YunBeeeen/Capstone/docs/media/SOURCES.md

# Media sources

- User-provided project portfolio: https://app.notion.com/p/3d252aba4c2a8006b0cac70a0ea84957
- User-provided PowerPoint: 포트폴리오_엄윤빈.pptx
- Photos and diagrams were extracted from those sources. Images were resized and optimized; transparent diagrams were placed on a white background for readability.
- Uploaded demo videos were transcoded to H.264 MP4 without audio. GIFs are short excerpts for README previews and do not represent a complete evaluation.
