YunBeeeen/Capstone/capstone_ws/src/description/meshes/mobile/wheel_fr_link.stl

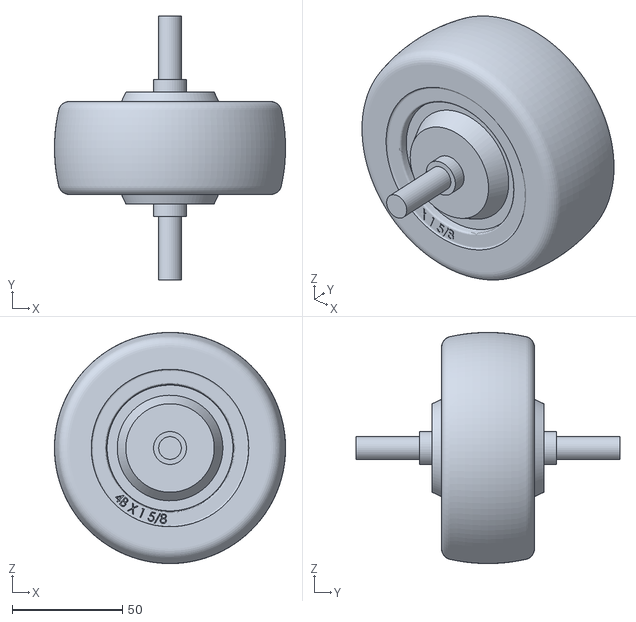
[picture p3: CAD file, 2026-11-08]
capstone_ws/src/description/meshes/mobile/wheel_fr_link.stl
105.0 x 119.9 x 105.0
