YunBeeeen/Capstone/capstone_ws/src/description/meshes/right_arm/camera/mounts/D435_Gemini2_Mount.stl

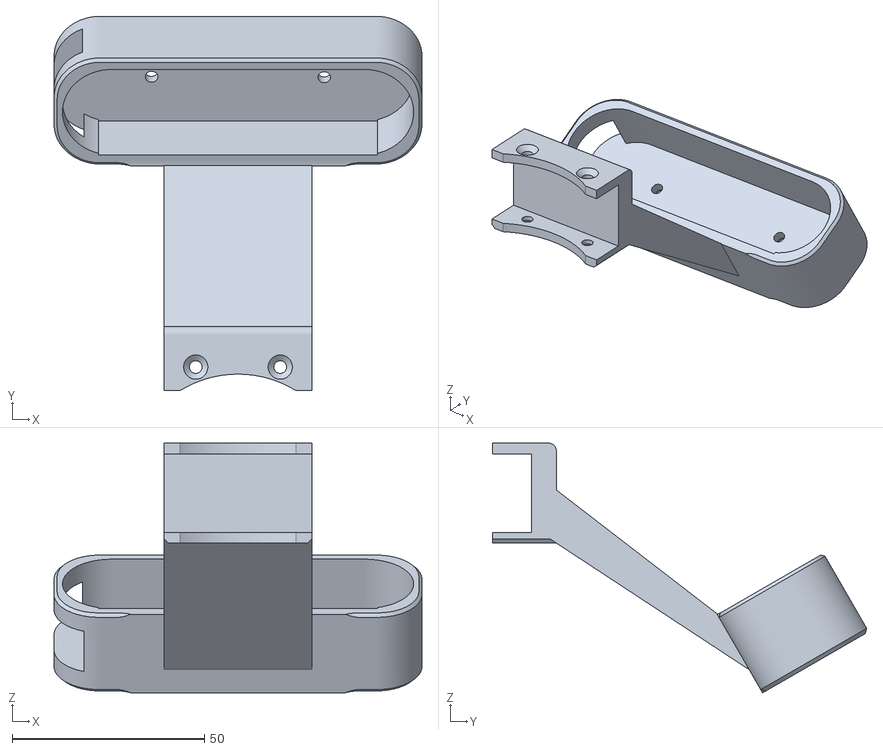
[picture p4: CAD file, 2026-11-08]
capstone_ws/src/description/meshes/right_arm/camera/mounts/D435_Gemini2_Mount.stl
95.8 x 97.4 x 65.0
