YunBeeeen/Capstone/capstone_ws/src/description/meshes/right_arm/camera/realsense/d435_1.stl

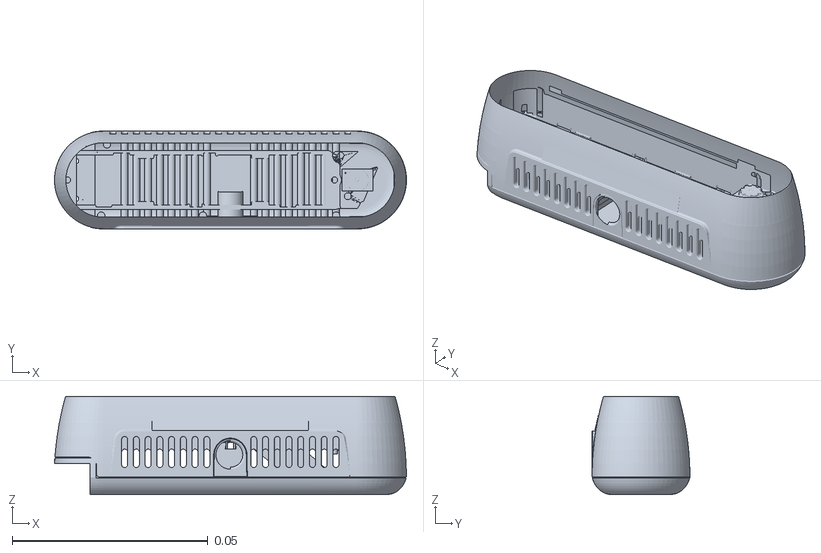
[picture p5: CAD file, 2026-11-08]
capstone_ws/src/description/meshes/right_arm/camera/realsense/d435_1.stl
0.0899 x 0.025 x 0.0251
