YunBeeeen/Capstone/capstone_ws/src/description/meshes/right_arm/collision/link2.STL

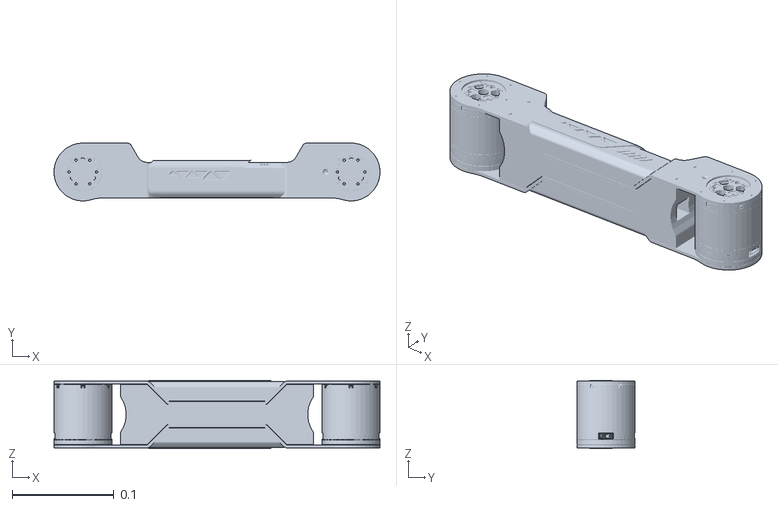
[picture p6: CAD file, 2026-11-08]
capstone_ws/src/description/meshes/right_arm/collision/link2.STL
0.321 x 0.057 x 0.0674
