YunBeeeen/Capstone/capstone_ws/src/description/meshes/right_arm/shared/colored_left_finger_carriage_grey.stl

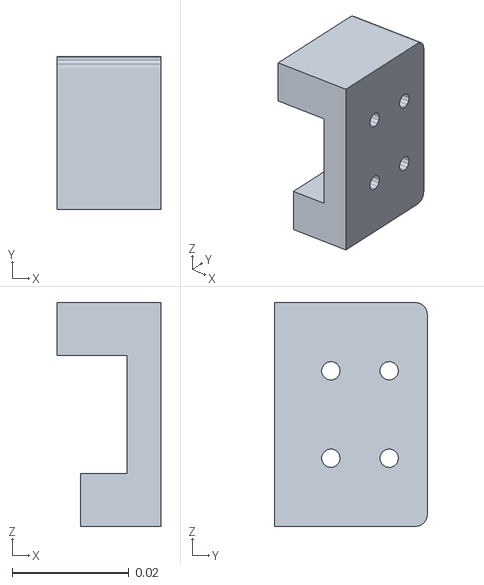
[picture p7: CAD file, 2026-11-08]
capstone_ws/src/description/meshes/right_arm/shared/colored_left_finger_carriage_grey.stl
0.0178 x 0.0262 x 0.0384
