YunBeeeen/Capstone/capstone_ws/src/description/meshes/right_arm/visual/colored_gripper_base_metal.stl

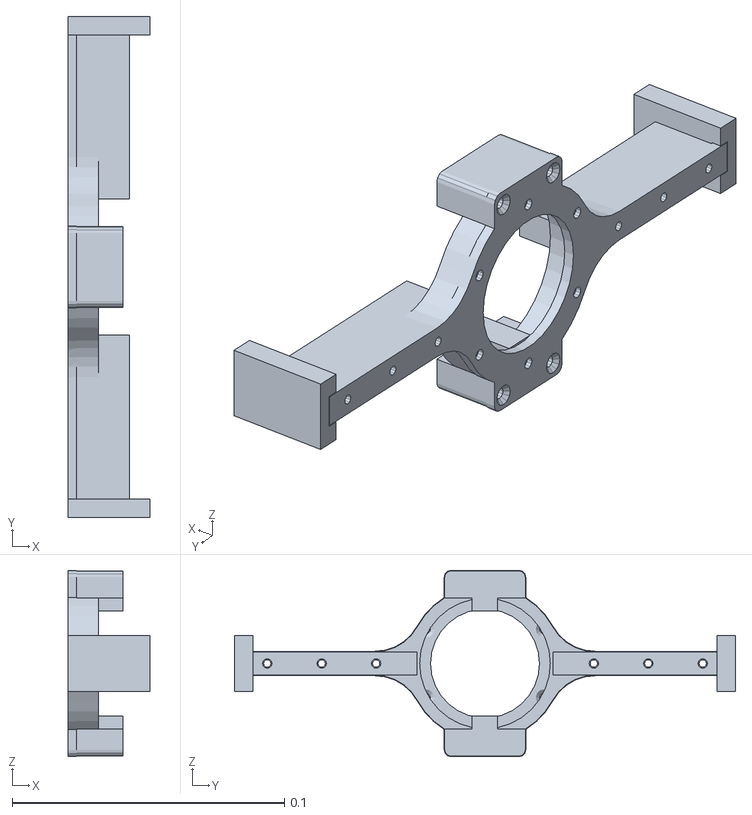
[picture p8: CAD file, 2026-11-08]
capstone_ws/src/description/meshes/right_arm/visual/colored_gripper_base_metal.stl
0.03 x 0.184 x 0.0685
