YunBeeeen/Capstone/capstone_ws/src/description/meshes/right_arm/camera/realsense/d435_0.stl

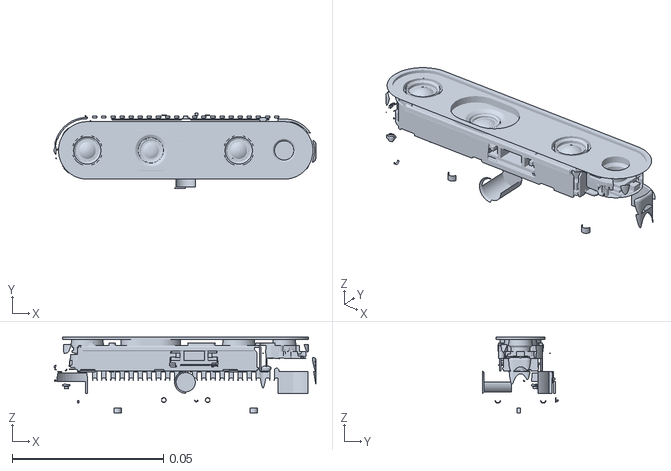
[picture p9: CAD file, 2026-11-08]
capstone_ws/src/description/meshes/right_arm/camera/realsense/d435_0.stl
0.0865 x 0.025 x 0.025
