YunBeeeen/Capstone/capstone_ws/src/description/meshes/right_arm/collision/left_finger.stl

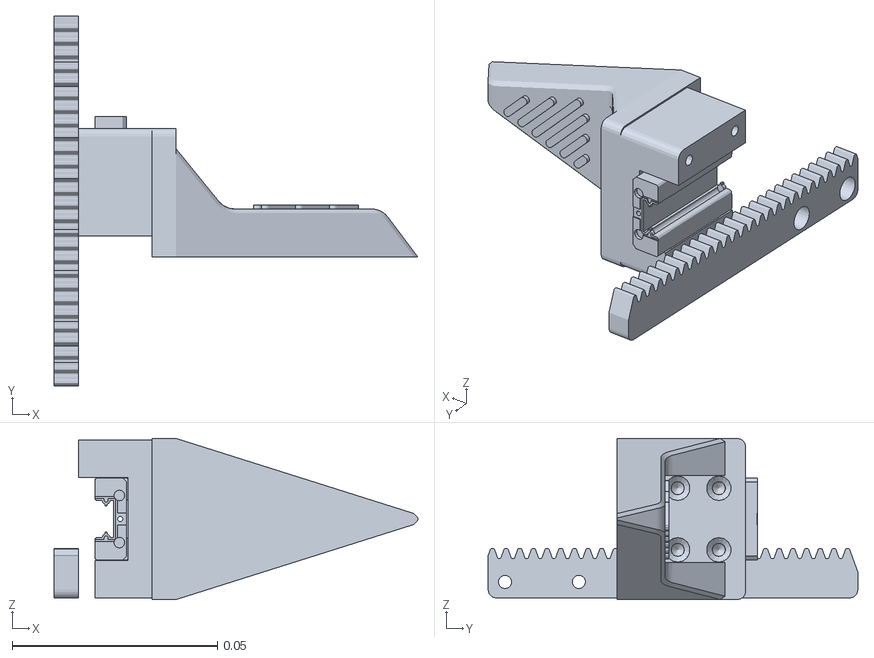
[picture p10: CAD file, 2026-11-08]
capstone_ws/src/description/meshes/right_arm/collision/left_finger.stl
0.0886 x 0.09 x 0.0392
