YunBeeeen/Capstone/capstone_ws/src/description/meshes/right_arm/shared/colored_right_finger_carriage_grey.stl

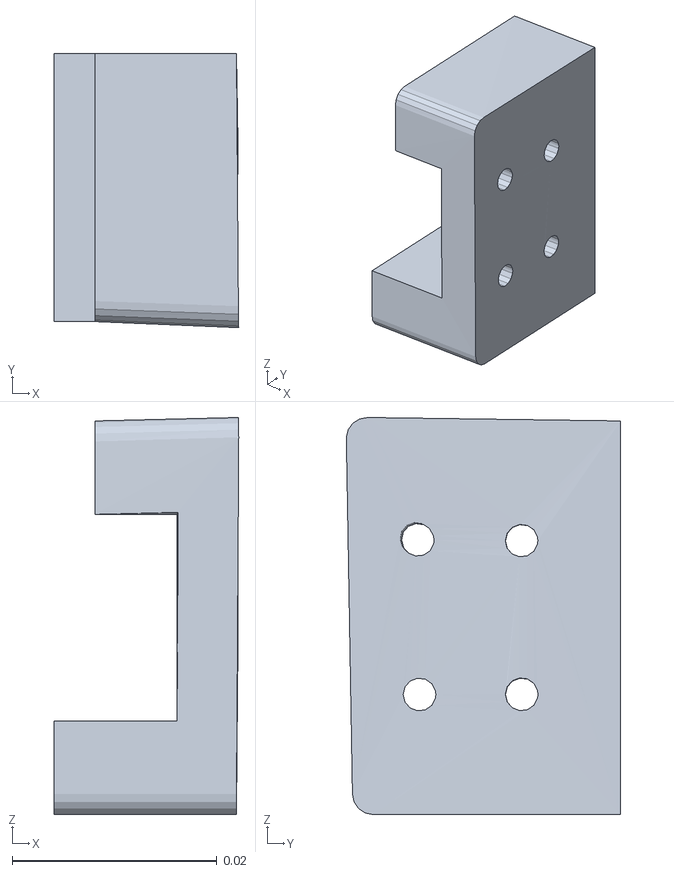
[picture p11: CAD file, 2026-11-08]
capstone_ws/src/description/meshes/right_arm/shared/colored_right_finger_carriage_grey.stl
0.018 x 0.0268 x 0.0388
