YunBeeeen/Capstone/capstone_ws/src/description/meshes/right_arm/visual/colored_link2_anodized_grey.stl

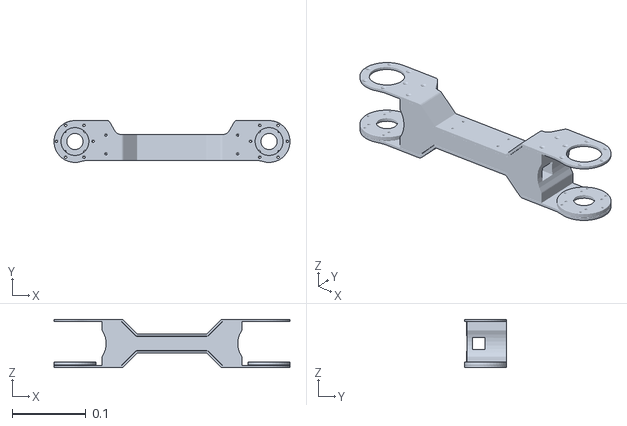
[picture p12: CAD file, 2026-11-08]
capstone_ws/src/description/meshes/right_arm/visual/colored_link2_anodized_grey.stl
0.321 x 0.057 x 0.0658
