YunBeeeen/Capstone/capstone_ws/src/description/meshes/mobile/steering_fl_link.stl

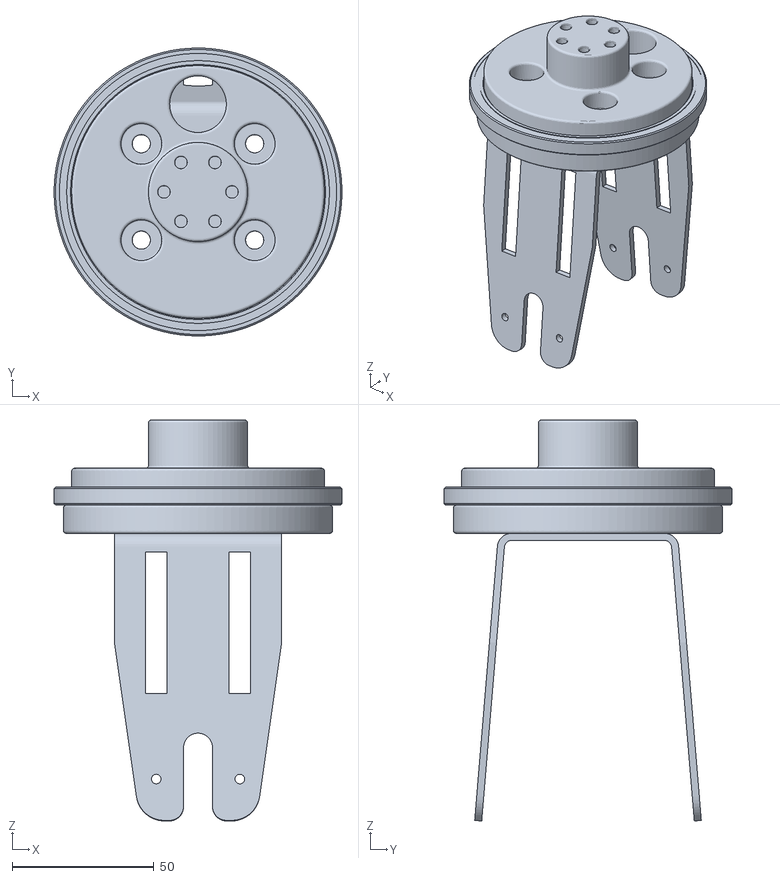
[picture p13: CAD file, 2026-11-08]
capstone_ws/src/description/meshes/mobile/steering_fl_link.stl
101.6 x 101.6 x 141.5
