YunBeeeen/Capstone/capstone_ws/src/description/meshes/right_arm/collision/link6.STL

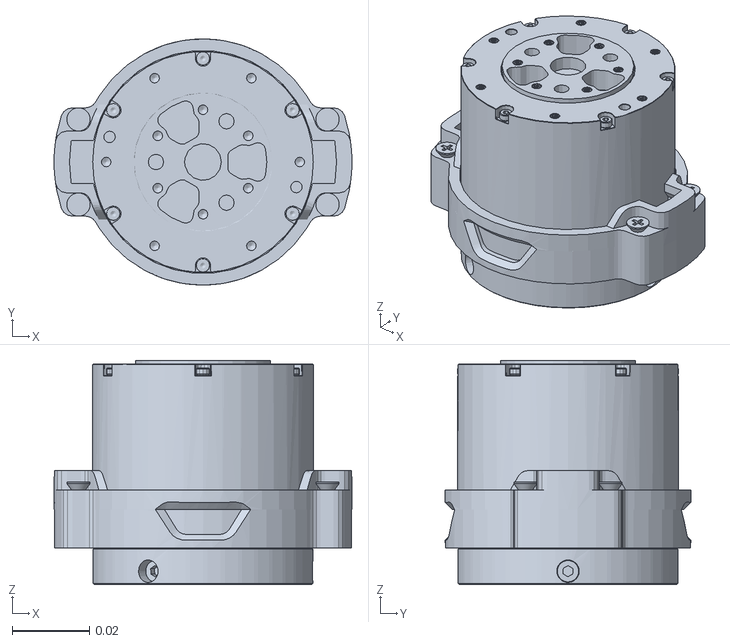
[picture p14: CAD file, 2026-11-08]
capstone_ws/src/description/meshes/right_arm/collision/link6.STL
0.077 x 0.0636 x 0.058
