YunBeeeen/Capstone/capstone_ws/src/description/meshes/right_arm/shared/colored_right_finger_travel_stop_yellow.stl

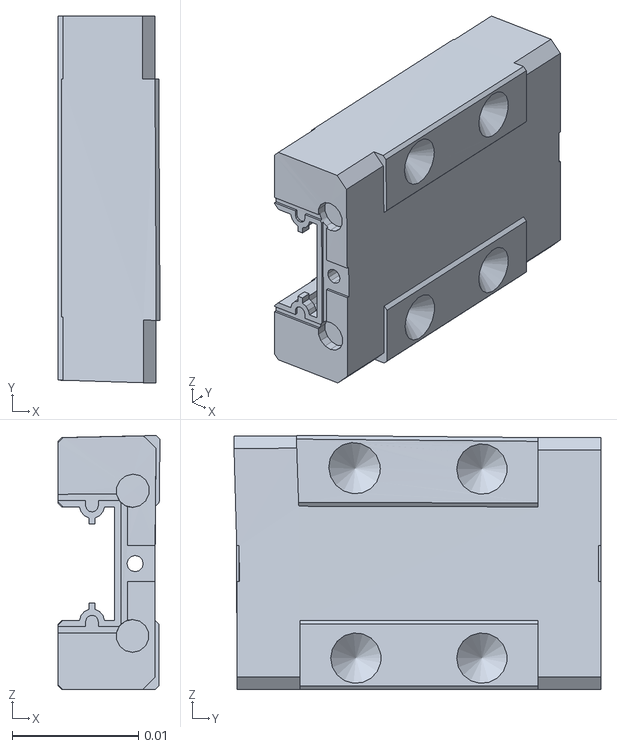
[picture p15: CAD file, 2026-11-08]
capstone_ws/src/description/meshes/right_arm/shared/colored_right_finger_travel_stop_yellow.stl
0.0081 x 0.0291 x 0.0202
