YunBeeeen/Capstone/capstone_ws/src/description/meshes/right_arm/visual/colored_link3_hardware_black.stl

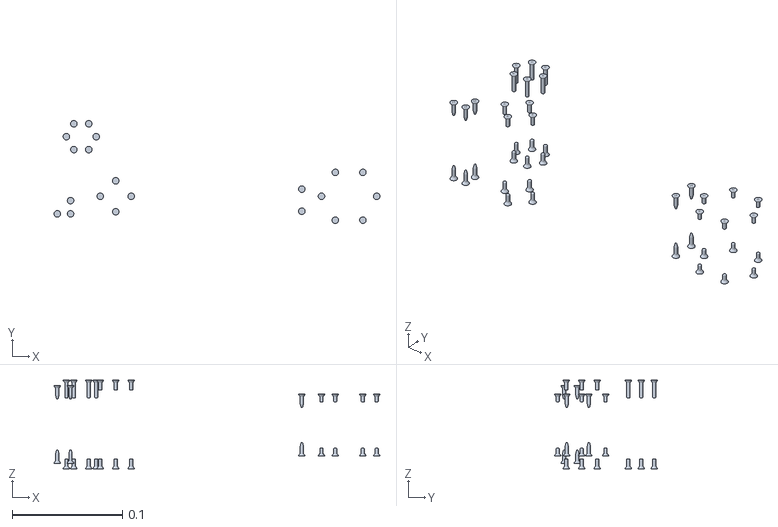
[picture p16: CAD file, 2026-11-08]
capstone_ws/src/description/meshes/right_arm/visual/colored_link3_hardware_black.stl
0.295 x 0.0933 x 0.0802
