YunBeeeen/Capstone/capstone_ws/src/description/meshes/mobile/lift_stage_2_link.stl

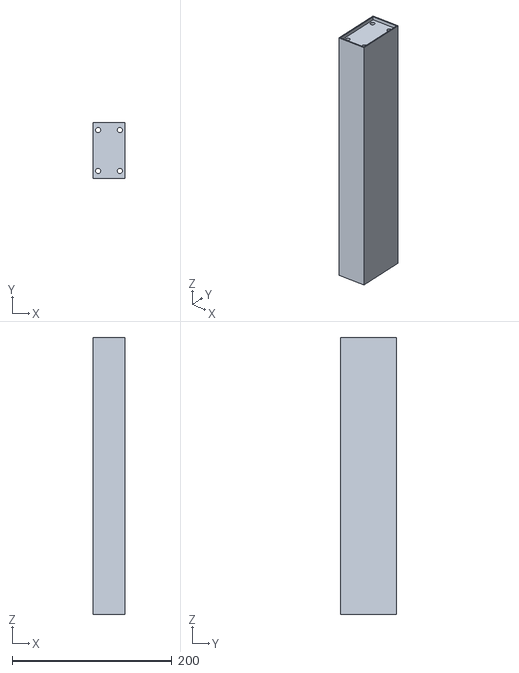
[picture p17: CAD file, 2026-11-08]
capstone_ws/src/description/meshes/mobile/lift_stage_2_link.stl
40.3 x 70.3 x 347.0
