YunBeeeen/Capstone/capstone_ws/src/description/meshes/right_arm/collision/gripper_base.stl

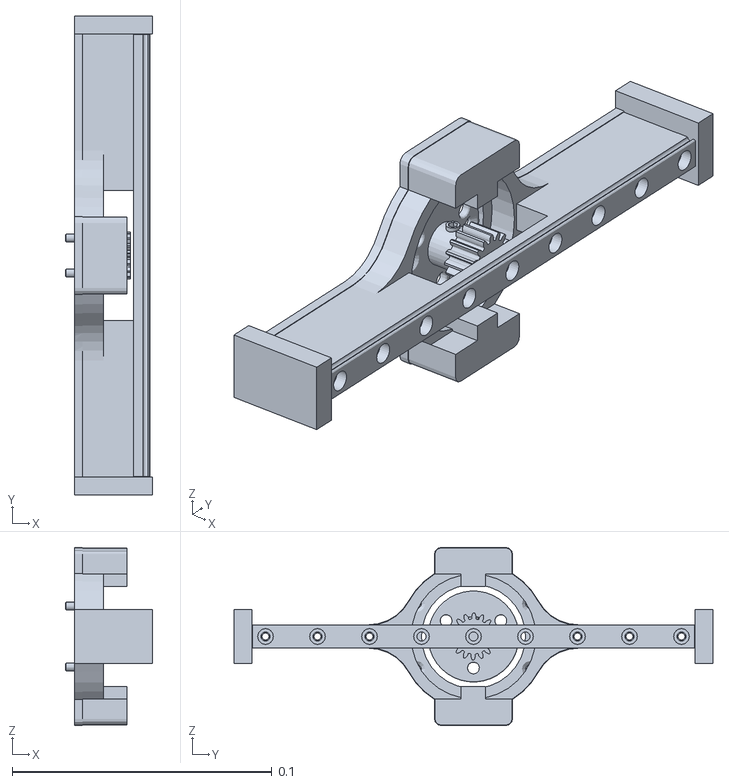
[picture p18: CAD file, 2026-11-08]
capstone_ws/src/description/meshes/right_arm/collision/gripper_base.stl
0.0335 x 0.184 x 0.0685
