YunBeeeen/Capstone/capstone_ws/src/description/meshes/right_arm/shared/colored_left_finger_travel_stop_yellow.stl

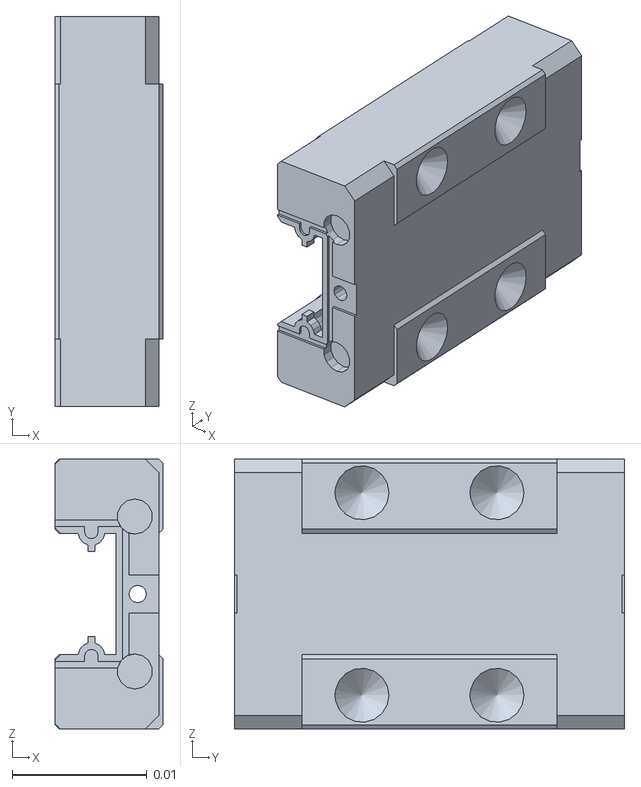
[picture p19: CAD file, 2026-11-08]
capstone_ws/src/description/meshes/right_arm/shared/colored_left_finger_travel_stop_yellow.stl
0.008 x 0.0289 x 0.02
