YunBeeeen/Capstone/capstone_ws/src/description/meshes/right_arm/visual/colored_base_link_silver_trim.stl

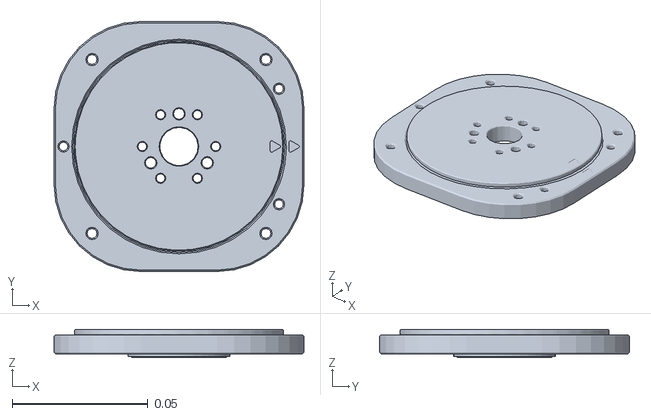
[picture p20: CAD file, 2026-11-08]
capstone_ws/src/description/meshes/right_arm/visual/colored_base_link_silver_trim.stl
0.092 x 0.092 x 0.0103
