YunBeeeen/Capstone/capstone_ws/src/description/meshes/mobile/front_camera_link.stl

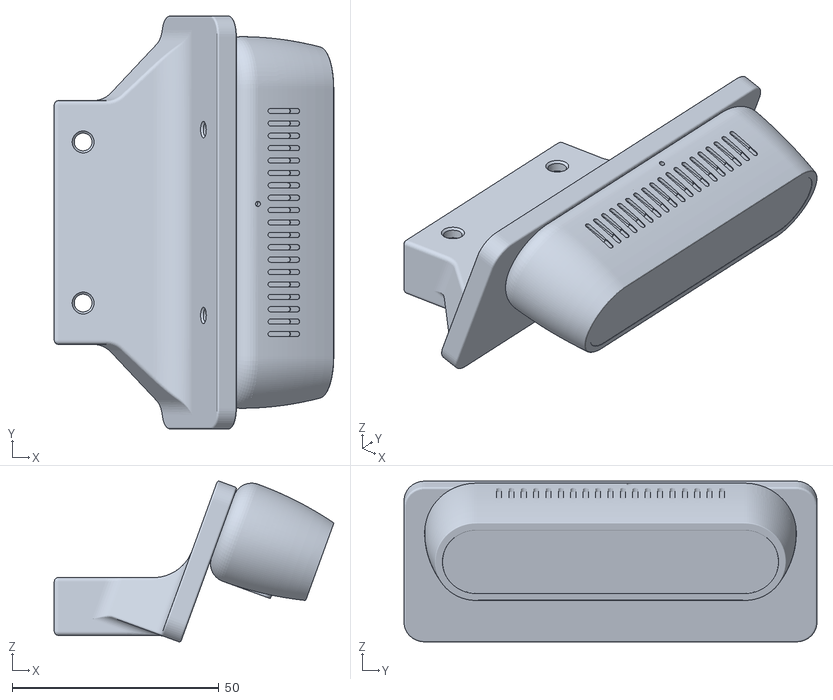
[picture p21: CAD file, 2026-11-08]
capstone_ws/src/description/meshes/mobile/front_camera_link.stl
67.7 x 100.0 x 38.9
