YunBeeeen/Capstone/capstone_ws/src/description/meshes/right_arm/collision/right_finger.stl

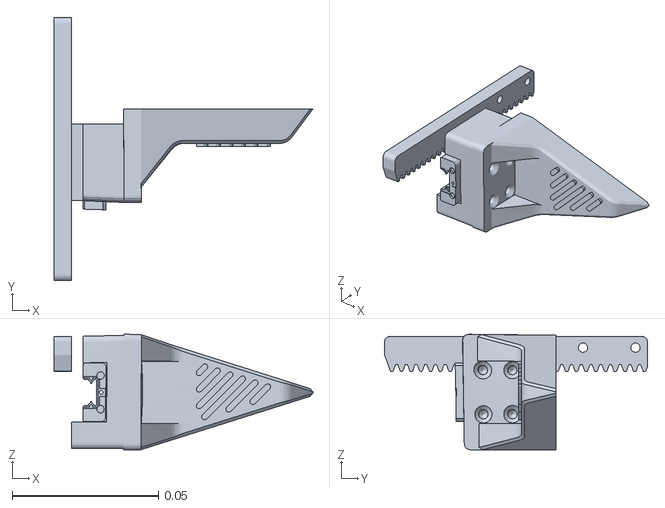
[picture p22: CAD file, 2026-11-08]
capstone_ws/src/description/meshes/right_arm/collision/right_finger.stl
0.0886 x 0.09 x 0.0395
