YunBeeeen/Capstone/capstone_ws/src/description/meshes/right_arm/visual/colored_link4_hardware_black.stl

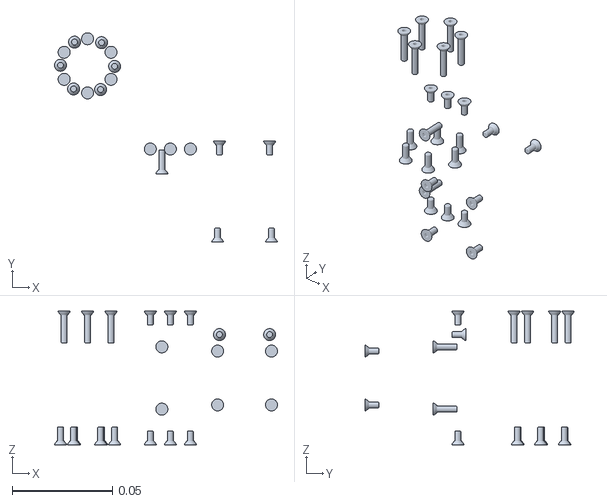
[picture p23: CAD file, 2026-11-08]
capstone_ws/src/description/meshes/right_arm/visual/colored_link4_hardware_black.stl
0.111 x 0.104 x 0.0668
