YunBeeeen/Capstone/capstone_ws/src/description/meshes/right_arm/collision/link5.STL

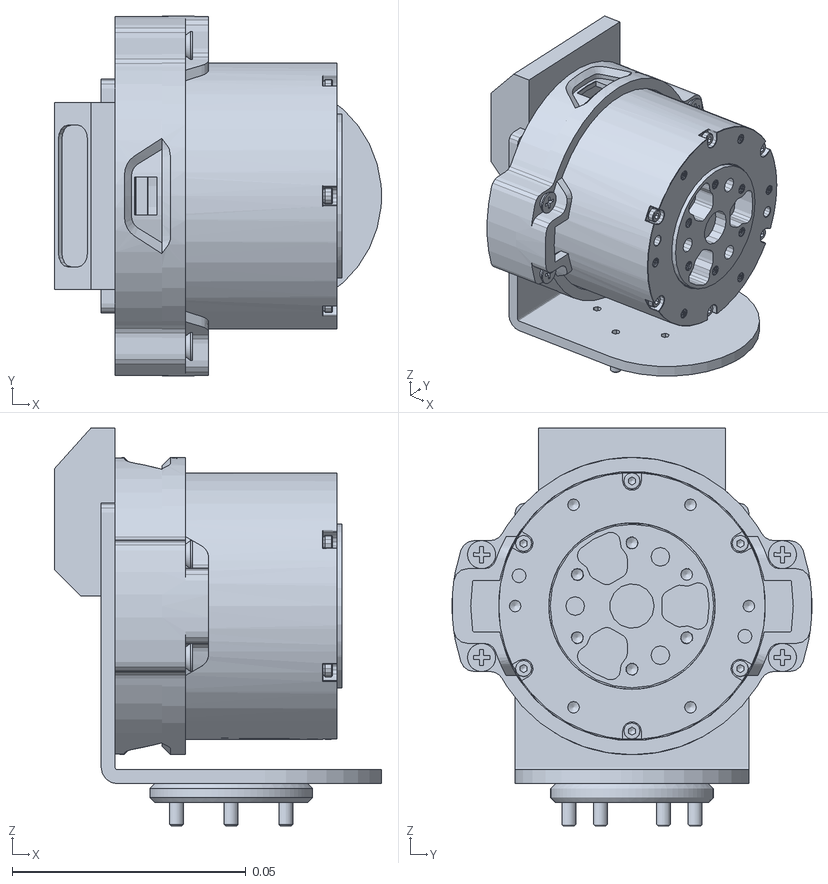
[picture p24: CAD file, 2026-11-08]
capstone_ws/src/description/meshes/right_arm/collision/link5.STL
0.07 x 0.077 x 0.085
