YunBeeeen/Capstone/capstone_ws/src/description/meshes/right_arm/visual/colored_link5_anodized_grey.stl

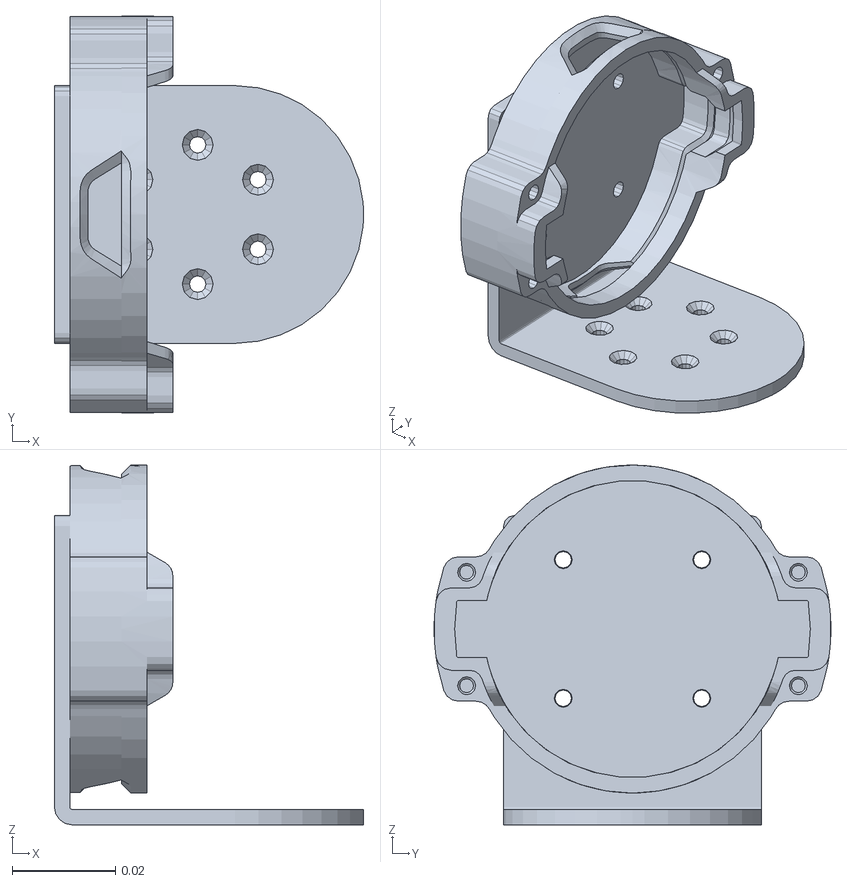
[picture p25: CAD file, 2026-11-08]
capstone_ws/src/description/meshes/right_arm/visual/colored_link5_anodized_grey.stl
0.06 x 0.077 x 0.0698
