YunBeeeen/Capstone/capstone_ws/src/description/meshes/right_arm/collision/link4.STL

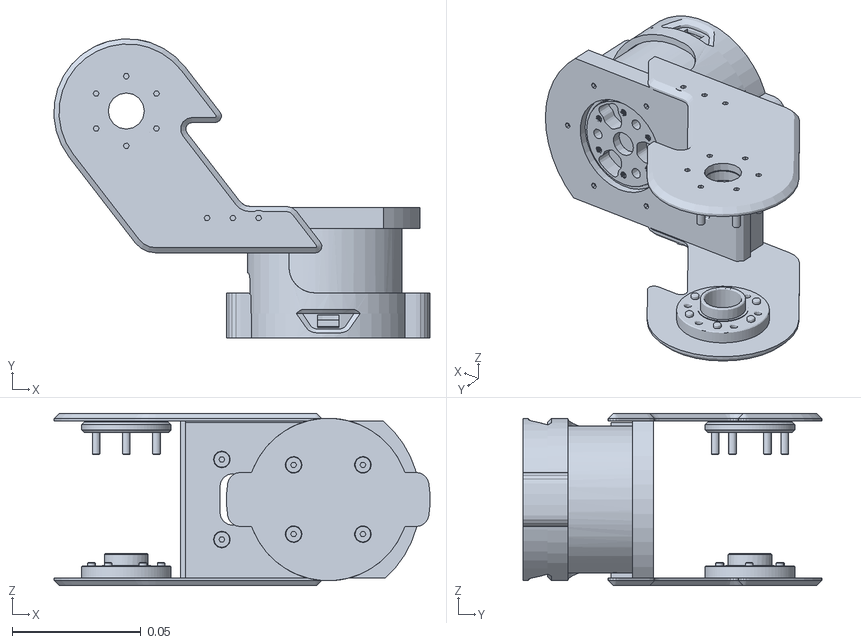
[picture p26: CAD file, 2026-11-08]
capstone_ws/src/description/meshes/right_arm/collision/link4.STL
0.146 x 0.116 x 0.0668
