YunBeeeen/Capstone/capstone_ws/src/description/meshes/right_arm/visual/colored_link5_matte_black.stl

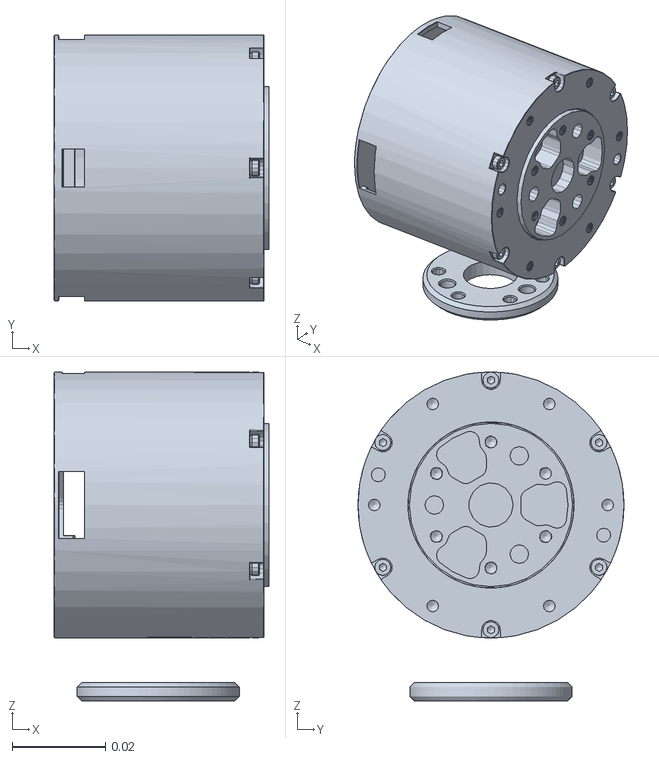
[picture p27: CAD file, 2026-11-08]
capstone_ws/src/description/meshes/right_arm/visual/colored_link5_matte_black.stl
0.046 x 0.057 x 0.0705
