YunBeeeen/Capstone/capstone_ws/src/description/meshes/mobile/base_link.stl

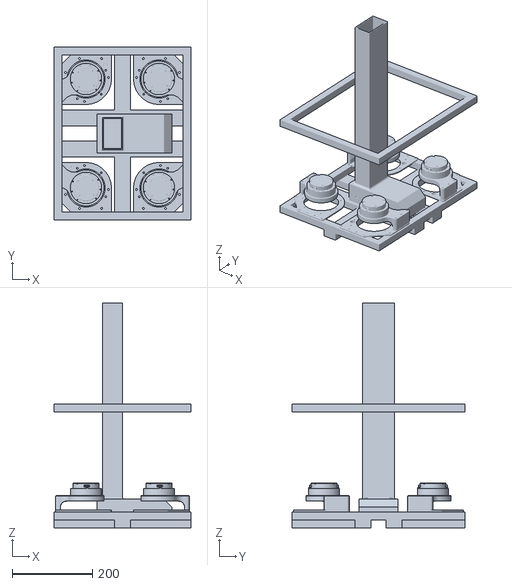
[picture p28: CAD file, 2026-11-08]
capstone_ws/src/description/meshes/mobile/base_link.stl
341.9 x 431.8 x 562.0
