YunBeeeen/Capstone/capstone_ws/src/description/meshes/right_arm/collision/link1.STL

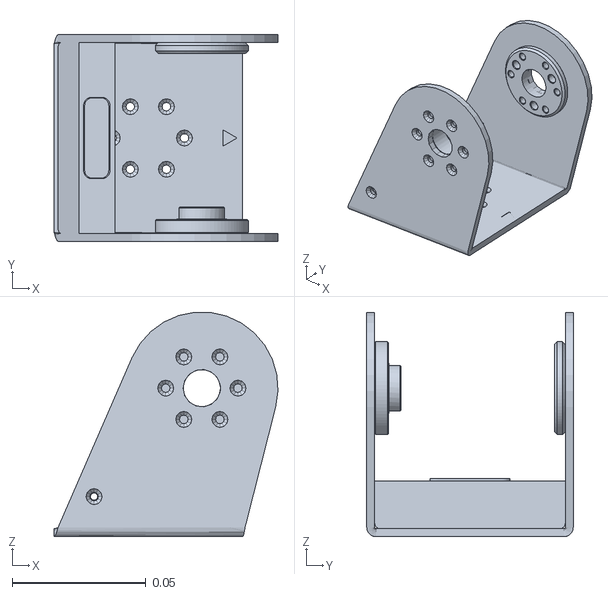
[picture p29: CAD file, 2026-11-08]
capstone_ws/src/description/meshes/right_arm/collision/link1.STL
0.0838 x 0.0772 x 0.0839
