YunBeeeen/Capstone/capstone_ws/src/description/meshes/right_arm/visual/colored_gripper_base_hardware_black.stl

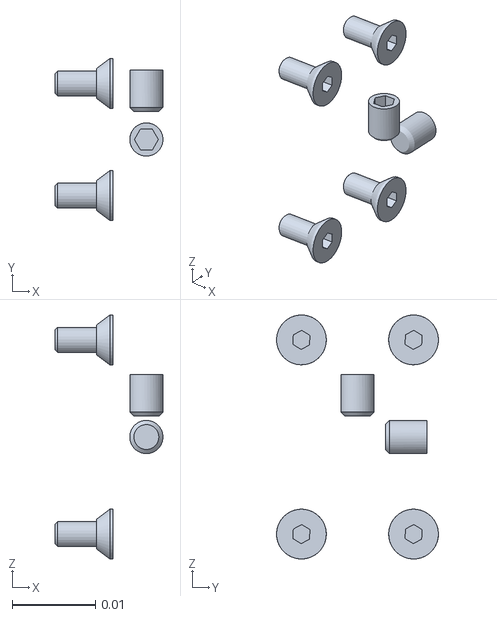
[picture p30: CAD file, 2026-11-08]
capstone_ws/src/description/meshes/right_arm/visual/colored_gripper_base_hardware_black.stl
0.013 x 0.0195 x 0.0294
