YunBeeeen/Capstone/capstone_ws/src/description/meshes/mobile/top_plate_link.stl

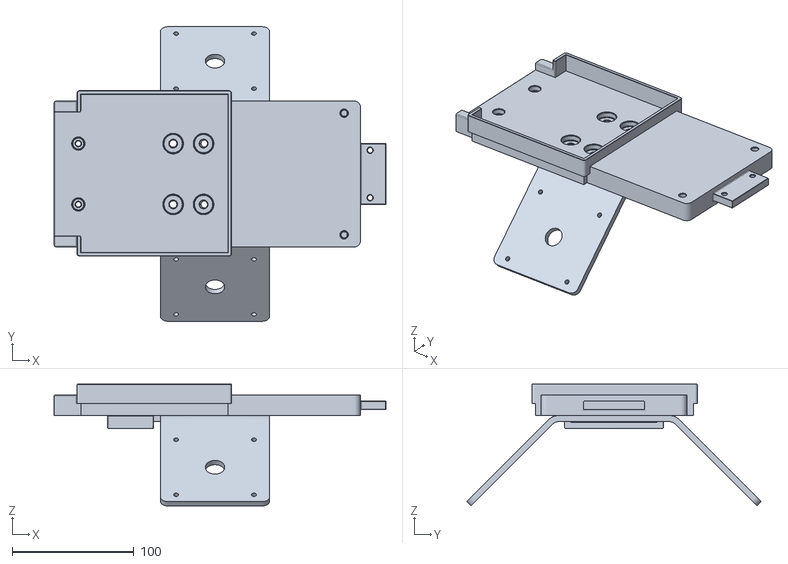
[picture p31: CAD file, 2026-11-08]
capstone_ws/src/description/meshes/mobile/top_plate_link.stl
273.0 x 242.2 x 100.2
