YunBeeeen/Capstone/capstone_ws/src/description/meshes/right_arm/collision/base_link_no_plate.stl

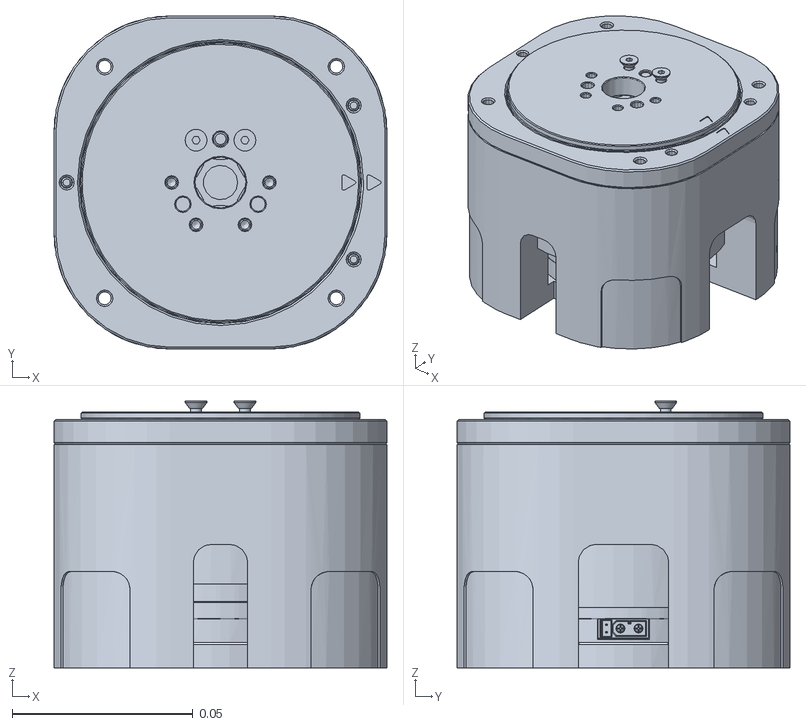
[picture p32: CAD file, 2026-11-08]
capstone_ws/src/description/meshes/right_arm/collision/base_link_no_plate.stl
0.092 x 0.092 x 0.0737
