YunBeeeen/Capstone/capstone_ws/src/description/meshes/right_arm/visual/colored_base_link_hardware_black_no_plate.stl

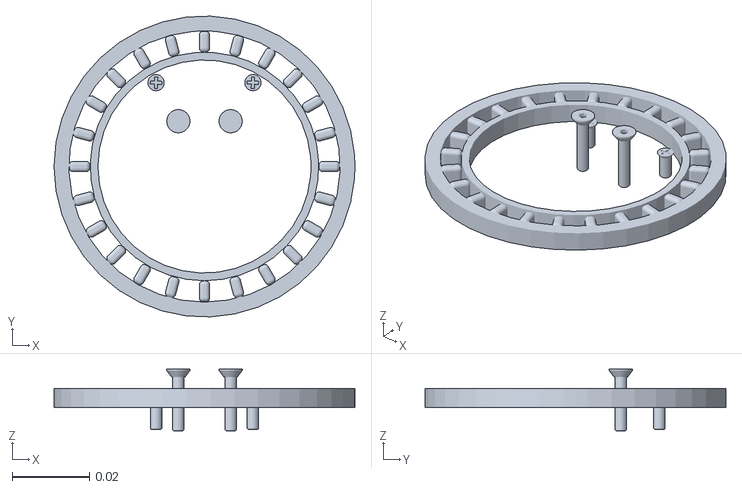
[picture p33: CAD file, 2026-11-08]
capstone_ws/src/description/meshes/right_arm/visual/colored_base_link_hardware_black_no_plate.stl
0.0777 x 0.0776 x 0.016
