YunBeeeen/Capstone/capstone_ws/src/description/meshes/right_arm/collision/link3.STL

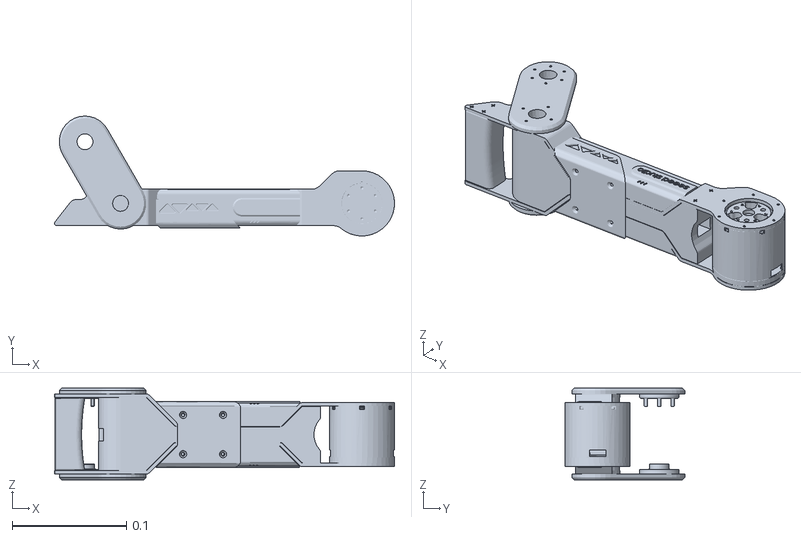
[picture p34: CAD file, 2026-11-08]
capstone_ws/src/description/meshes/right_arm/collision/link3.STL
0.298 x 0.105 x 0.0802
