YunBeeeen/Capstone/capstone_ws/src/description/meshes/right_arm/visual/colored_link4_anodized_grey.stl

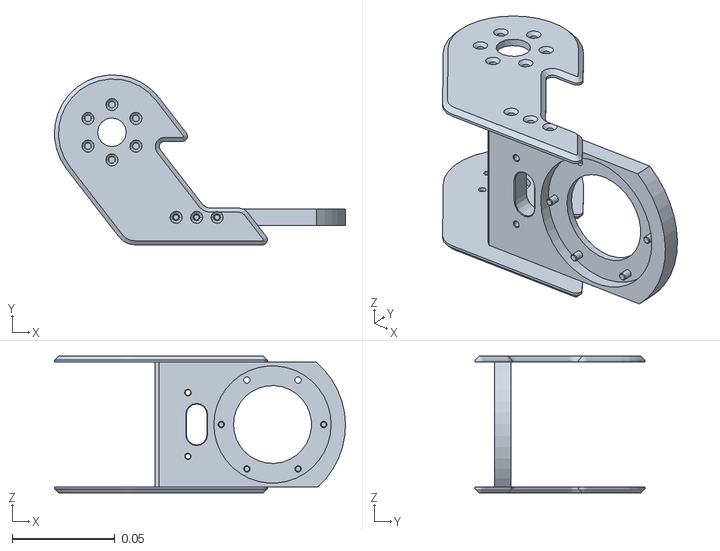
[picture p35: CAD file, 2026-11-08]
capstone_ws/src/description/meshes/right_arm/visual/colored_link4_anodized_grey.stl
0.142 x 0.0829 x 0.0668
