YunBeeeen/Capstone/capstone_ws/src/description/meshes/mobile/lift_stage_1_link.stl

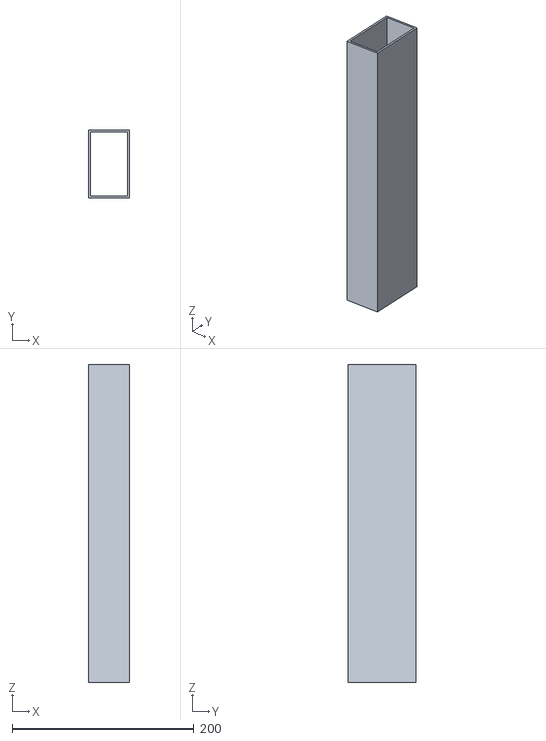
[picture p36: CAD file, 2026-11-08]
capstone_ws/src/description/meshes/mobile/lift_stage_1_link.stl
45.4 x 75.2 x 350.0
