YunBeeeen/Capstone/capstone_ws/src/description/meshes/right_arm/visual/colored_link4_matte_black.stl

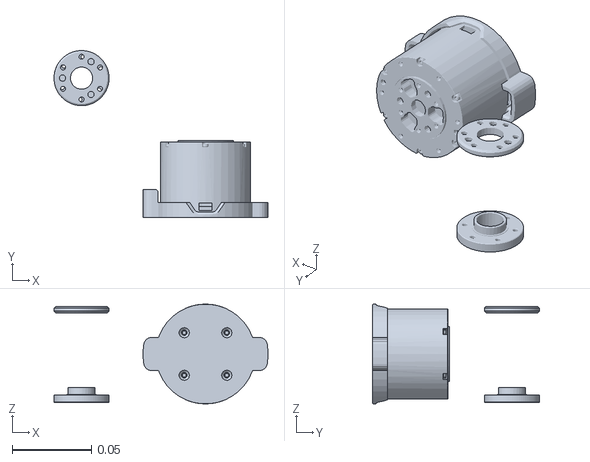
[picture p37: CAD file, 2026-11-08]
capstone_ws/src/description/meshes/right_arm/visual/colored_link4_matte_black.stl
0.135 x 0.105 x 0.063
