YunBeeeen/Capstone/capstone_ws/src/description/meshes/right_arm/visual/colored_link3_matte_black.stl

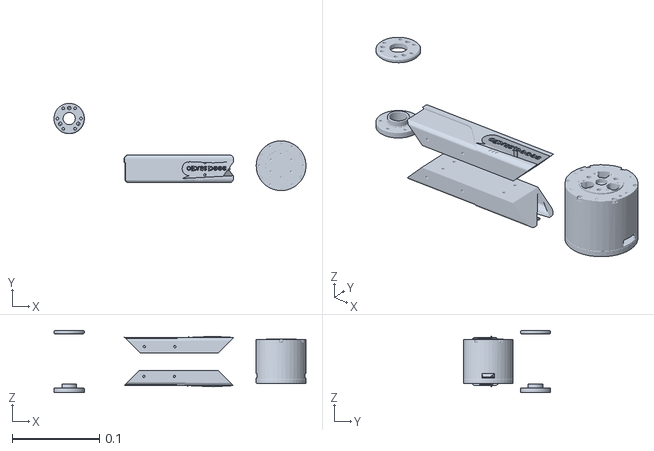
[picture p38: CAD file, 2026-11-08]
capstone_ws/src/description/meshes/right_arm/visual/colored_link3_matte_black.stl
0.288 x 0.0999 x 0.0712
