YunBeeeen/Capstone/capstone_ws/src/description/meshes/right_arm/visual/colored_right_finger_rack_metal.stl

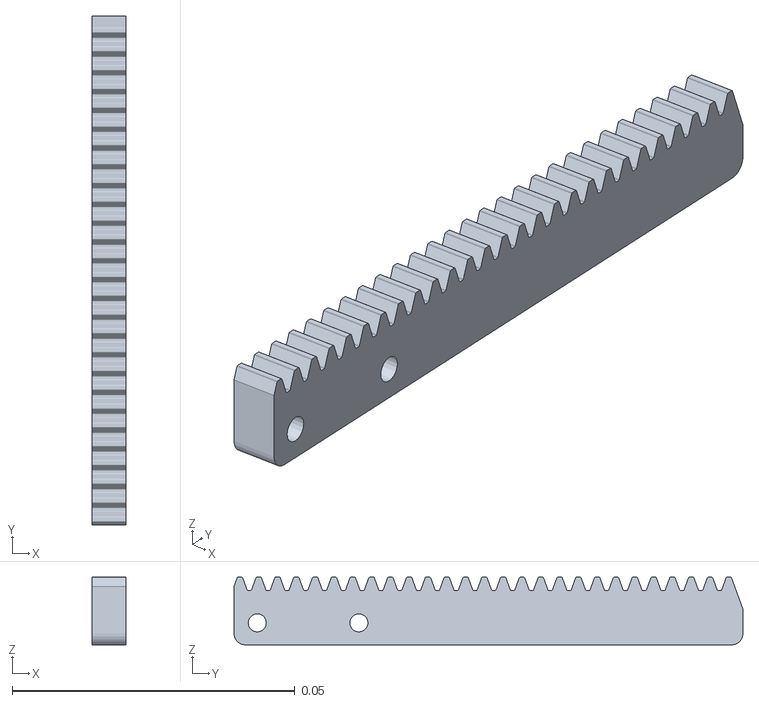
[picture p39: CAD file, 2026-11-08]
capstone_ws/src/description/meshes/right_arm/visual/colored_right_finger_rack_metal.stl
0.006 x 0.09 x 0.012
