YunBeeeen/Capstone/capstone_ws/src/description/meshes/right_arm/visual/colored_link3_anodized_grey.stl

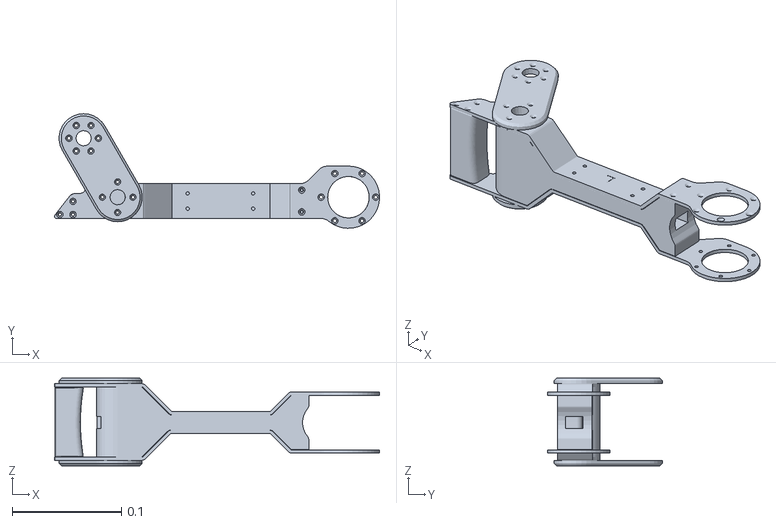
[picture p40: CAD file, 2026-11-08]
capstone_ws/src/description/meshes/right_arm/visual/colored_link3_anodized_grey.stl
0.298 x 0.105 x 0.0802
