YunBeeeen/Capstone/capstone_ws/src/description/meshes/right_arm/visual/colored_link1_hardware_black.stl

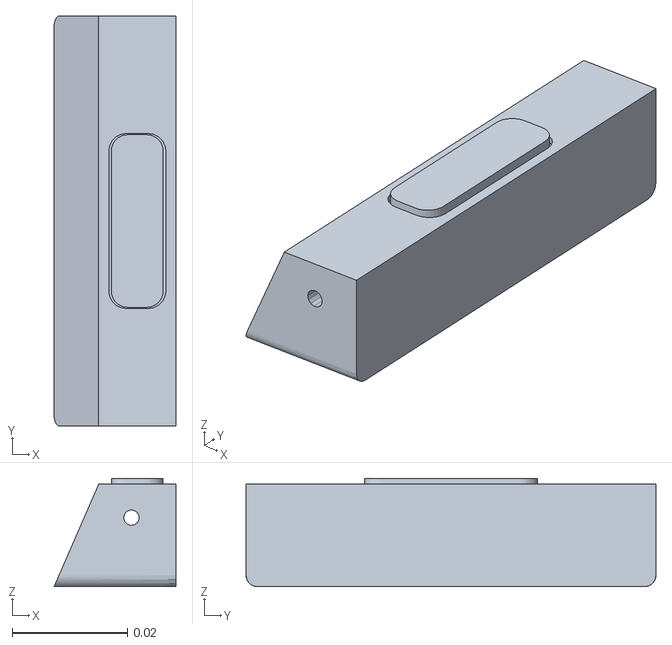
[picture p42: CAD file, 2026-11-08]
capstone_ws/src/description/meshes/right_arm/visual/colored_link1_hardware_black.stl
0.0212 x 0.0712 x 0.0188
