YunBeeeen/Capstone/capstone_ws/src/description/meshes/right_arm/visual/colored_link4_seeed_yellow.stl

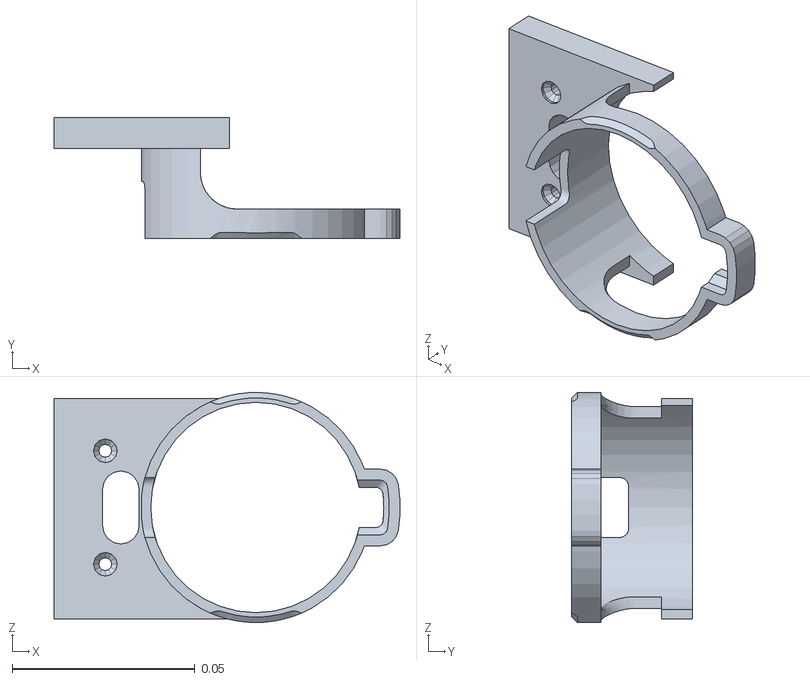
[picture p43: CAD file, 2026-11-08]
capstone_ws/src/description/meshes/right_arm/visual/colored_link4_seeed_yellow.stl
0.0948 x 0.033 x 0.063
