YunBeeeen/Capstone/capstone_ws/src/description/meshes/right_arm/visual/colored_link1_matte_black.stl

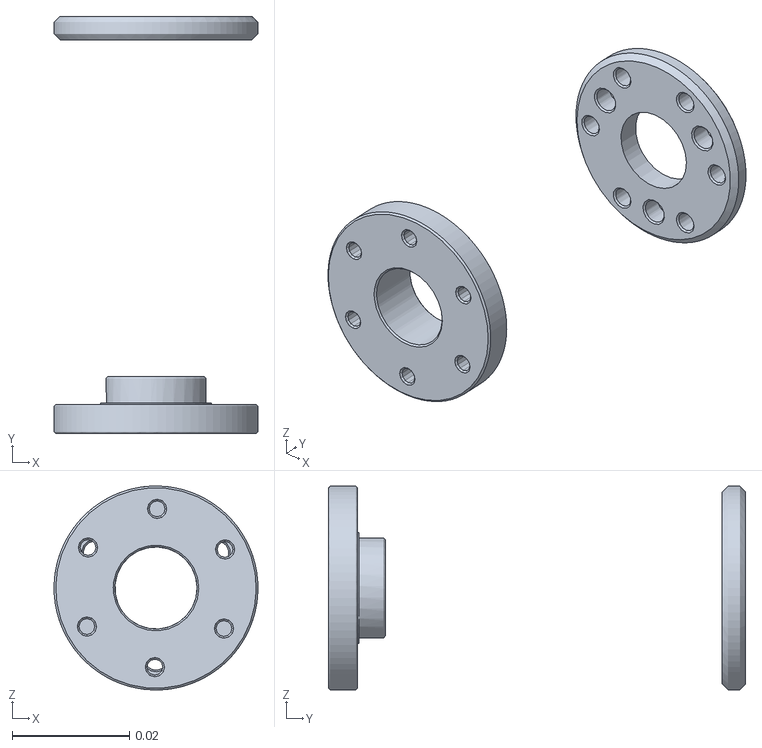
[picture p45: CAD file, 2026-11-08]
capstone_ws/src/description/meshes/right_arm/visual/colored_link1_matte_black.stl
0.0348 x 0.0712 x 0.0348
