YunBeeeen/Capstone/capstone_ws/src/description/meshes/right_arm/visual/colored_link3_seeed_yellow.stl

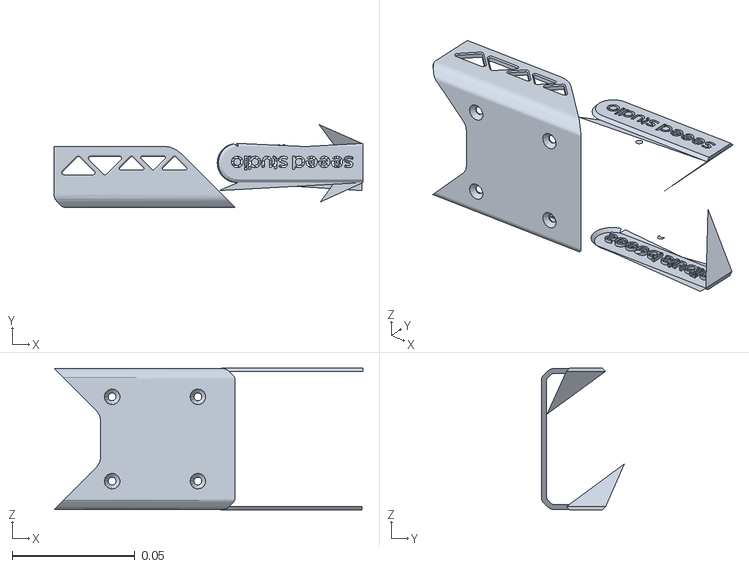
[picture p46: CAD file, 2026-11-08]
capstone_ws/src/description/meshes/right_arm/visual/colored_link3_seeed_yellow.stl
0.126 x 0.0338 x 0.0578
