YunBeeeen/Capstone/capstone_ws/src/description/meshes/right_arm/visual/colored_link1_anodized_grey.stl

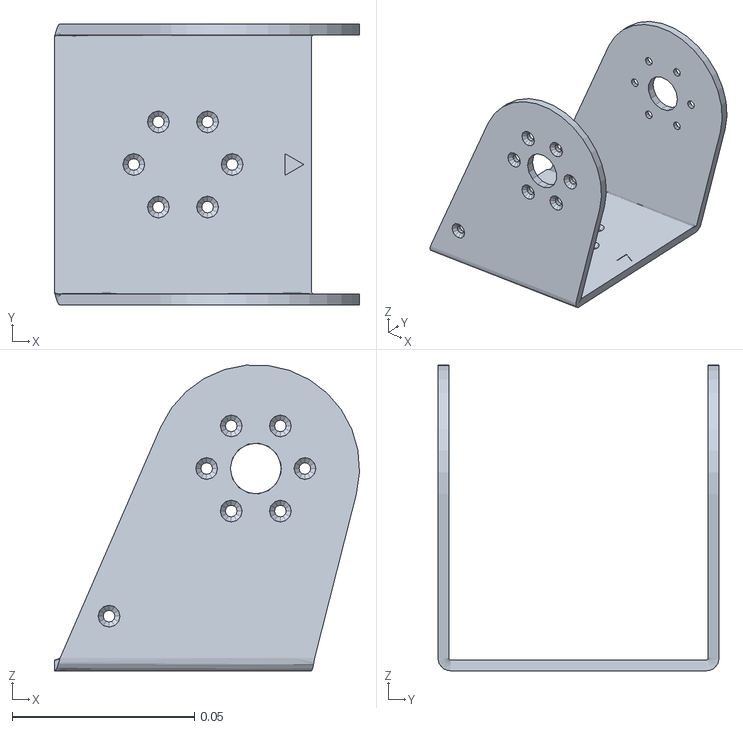
[picture p47: CAD file, 2026-11-08]
capstone_ws/src/description/meshes/right_arm/visual/colored_link1_anodized_grey.stl
0.0838 x 0.0772 x 0.0839
