YunBeeeen/Capstone/capstone_ws/src/description/meshes/right_arm/visual/colored_link5_hardware_black.stl

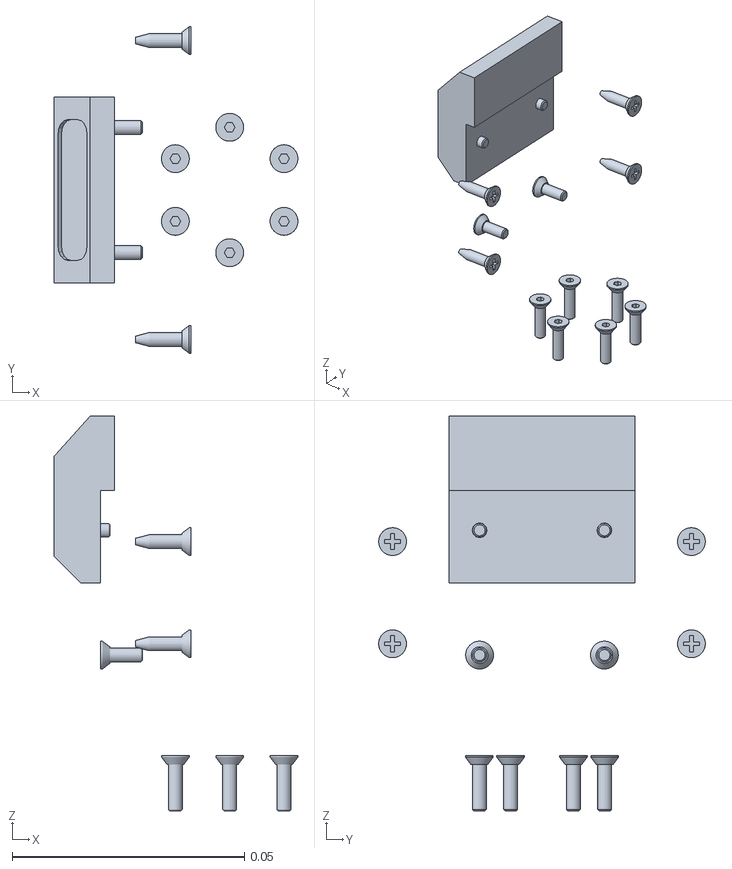
[picture p48: CAD file, 2026-11-08]
capstone_ws/src/description/meshes/right_arm/visual/colored_link5_hardware_black.stl
0.0525 x 0.0703 x 0.085
