YunBeeeen/Capstone/capstone_ws/src/description/meshes/right_arm/visual/colored_link2_hardware_black.stl

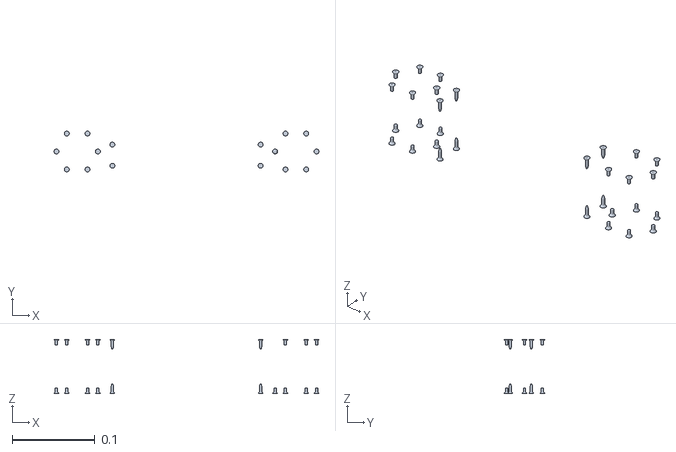
[picture p49: CAD file, 2026-11-08]
capstone_ws/src/description/meshes/right_arm/visual/colored_link2_hardware_black.stl
0.32 x 0.0493 x 0.0657
