YunBeeeen/Capstone/capstone_ws/src/description/meshes/right_arm/visual/colored_base_link_matte_black_no_plate.stl

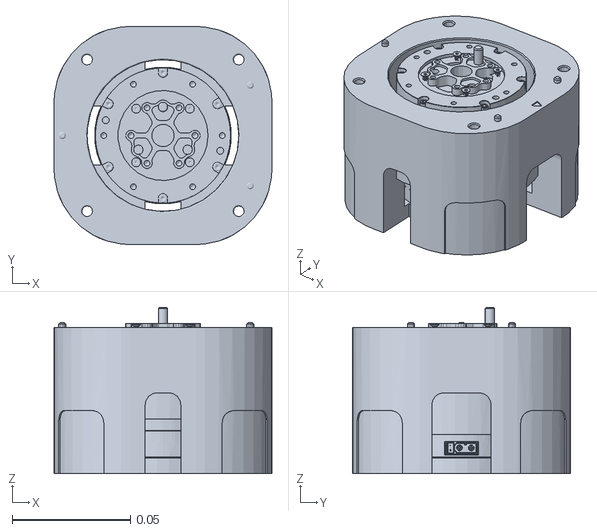
[picture p50: CAD file, 2026-11-08]
capstone_ws/src/description/meshes/right_arm/visual/colored_base_link_matte_black_no_plate.stl
0.092 x 0.092 x 0.0702
