YunBeeeen/Capstone/capstone_ws/src/description/meshes/right_arm/visual/colored_link6_hardware_black.stl

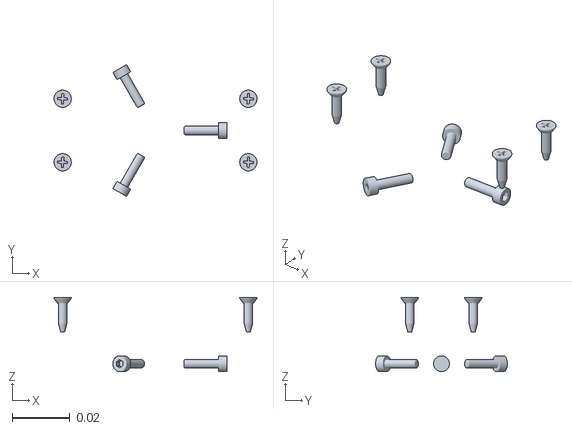
[picture p51: CAD file, 2026-11-08]
capstone_ws/src/description/meshes/right_arm/visual/colored_link6_hardware_black.stl
0.0703 x 0.0457 x 0.0257
