YunBeeeen/Capstone/capstone_ws/src/description/meshes/right_arm/visual/colored_gripper_base_seeed_yellow.stl

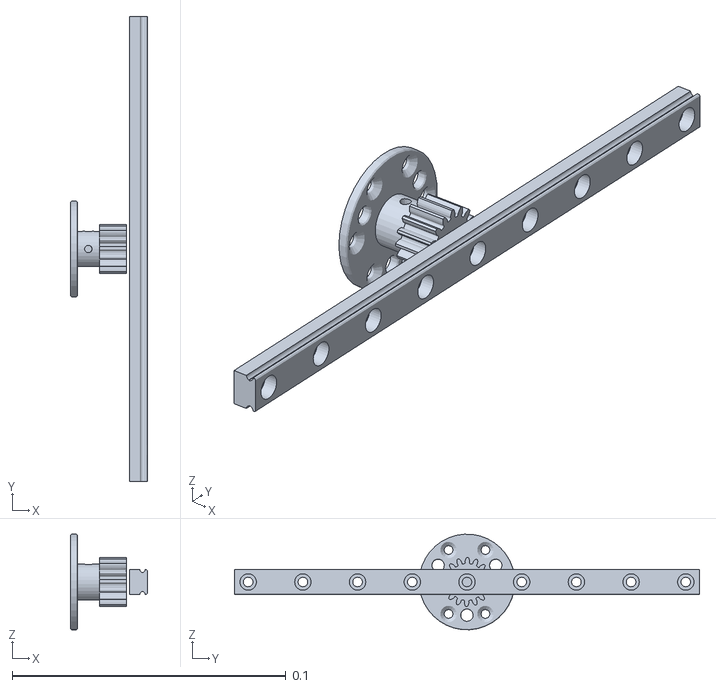
[picture p52: CAD file, 2026-11-08]
capstone_ws/src/description/meshes/right_arm/visual/colored_gripper_base_seeed_yellow.stl
0.0281 x 0.17 x 0.0349
