YunBeeeen/Capstone/capstone_ws/src/description/meshes/right_arm/visual/colored_right_finger_finger_black.stl

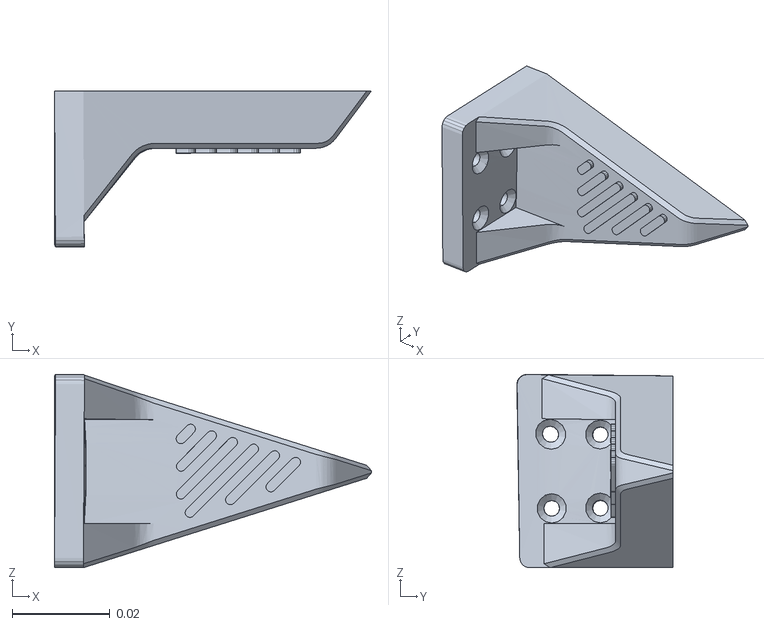
[picture p53: CAD file, 2026-11-08]
capstone_ws/src/description/meshes/right_arm/visual/colored_right_finger_finger_black.stl
0.0648 x 0.032 x 0.0395
