YunBeeeen/Capstone/capstone_ws/src/description/meshes/right_arm/visual/colored_link6_matte_black.stl

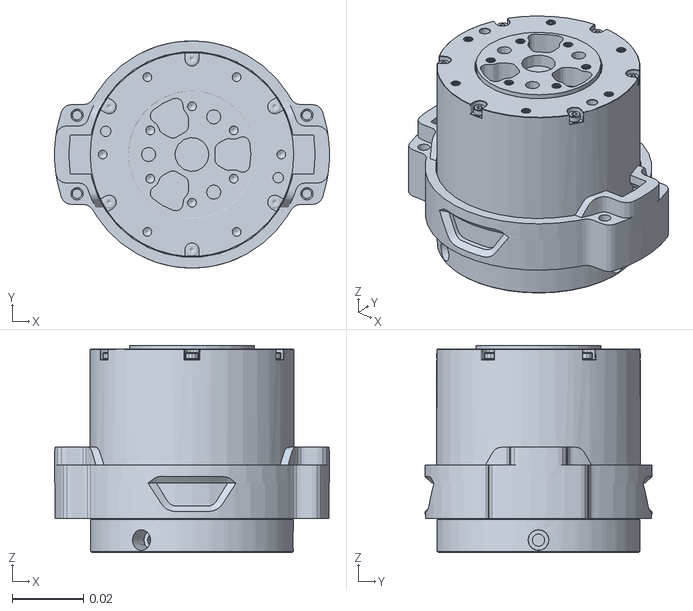
[picture p54: CAD file, 2026-11-08]
capstone_ws/src/description/meshes/right_arm/visual/colored_link6_matte_black.stl
0.077 x 0.0636 x 0.058
