YunBeeeen/Capstone/capstone_ws/src/description/meshes/right_arm/visual/colored_link2_seeed_yellow.stl

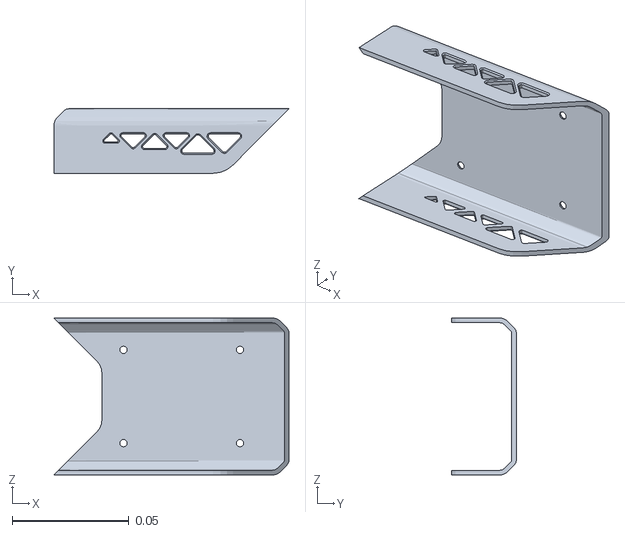
[picture p55: CAD file, 2026-11-08]
capstone_ws/src/description/meshes/right_arm/visual/colored_link2_seeed_yellow.stl
0.101 x 0.0277 x 0.0674
