YunBeeeen/Capstone/(list of files, cad)

Other CAD files:
capstone_ws/src/description/meshes/mobile/wheel_rl_link.stl
capstone_ws/src/description/meshes/mobile/steering_rr_link.stl
capstone_ws/src/description/meshes/mobile/wheel_fl_link.stl
capstone_ws/src/description/meshes/mobile/steering_rl_link.stl
capstone_ws/src/description/meshes/mobile/steering_fr_link.stl
capstone_ws/src/description/meshes/mobile/wheel_rr_link.stl
capstone_ws/src/description/meshes/right_arm/visual/colored_left_finger_rack_metal.stl
