YunBeeeen/Capstone/capstone_ws/Steer_motor/steer_can/tests/rs02_vectors.csv

# RS02 private 프로토콜 공용 테스트 벡터 — Python(tests/test_rs02.py)과 C++(steer_can_bridge test)이 같이 읽음.
# 생성: python3 -m tests.gen_vectors (lib 가 기준). 손으로 고치지 말 것.
# kind | can_id | a | b | c | d | e | arb_id_hex | data_hex
# 인코드 (Pi→모터 | host_id=0xFD): enable / stop(a=clear_fault) / mit(a=p | b=v | c=kp | d=kd | e=t) / write_f32(a=index | b=value)
# 디코드 (모터→Pi): feedback(a=pos | b=vel | c=tor | d=temp | e=flags = mode<<6 | fault)
# mit 의 p=0 / v=0 / t=0 은 u16 변환이 정확히 x.5 → 반올림 규칙(짝수 쪽)까지 맞는지 확인
enable | 1 |  |  |  |  |  | 0300FD01 | 0000000000000000
enable | 4 |  |  |  |  |  | 0300FD04 | 0000000000000000
enable | 127 |  |  |  |  |  | 0300FD7F | 0000000000000000
stop | 1 | 0 |  |  |  |  | 0400FD01 | 0000000000000000
stop | 2 | 1 |  |  |  |  | 0400FD02 | 0100000000000000
mit | 1 | 0.0 | 0.0 | 20.0 | 2.0 | 0.0 | 01800001 | 800080000a3d6666
mit | 2 | 1.5707963267948966 | 1.5 | 20.0 | 2.0 | 0.0 | 01800002 | 8fff845d0a3d6666
mit | 3 | -2.9670597283903604 | -2.0 | 30.0 | 2.2 | 0.0 | 01800003 | 61c77a2e0f5c70a3
mit | 4 | 2.5 | 0.0 | 250.0 | 2.5 | 0.0 | 01800004 | 9976800080008000
mit | 1 | -0.1234 | 0.25 | 5.0 | 0.5 | 1.5 | 018B4B01 | 7ebe80ba028f199a
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
