YunBeeeen/Capstone/capstone_ws/src/description/mjcf/mobile_robot_right_arm.xml

<!-- 자동 생성: src/sim/scripts/build_mjcf.py (원본 urdf/mobile_robot_right_arm.urdf). 직접 고치지 말고 URDF/생성기를 고친 뒤 다시 실행. 질량은 추정값. -->
<mujoco model="mobile_robot_right_arm">
  <compiler angle="radian" meshdir="../meshes"/>

  <option integrator="implicitfast"/>

  <size nkey="1"/>

  <visual>
    <global offwidth="1280" offheight="960"/>
    <headlight ambient="0.35 0.35 0.35"/>
  </visual>

  <asset>
    <texture type="2d" colorspace="auto" name="grid" builtin="checker" rgb1="0.82 0.82 0.85" rgb2="0.7 0.7 0.74" width="512" height="512"/>
    <material name="grid" texture="grid" texrepeat="8 8" reflectance="0.05"/>
    <mesh name="base_link" file="mobile/base_link.stl" scale="0.001 0.001 0.001"/>
    <mesh name="steering_fl_link" file="mobile/steering_fl_link.stl" scale="0.001 0.001 0.001"/>
    <mesh name="steering_fr_link" file="mobile/steering_fr_link.stl" scale="0.001 0.001 0.001"/>
    <mesh name="steering_rl_link" file="mobile/steering_rl_link.stl" scale="0.001 0.001 0.001"/>
    <mesh name="steering_rr_link" file="mobile/steering_rr_link.stl" scale="0.001 0.001 0.001"/>
    <mesh name="wheel_fl_link" file="mobile/wheel_fl_link.stl" scale="0.001 0.001 0.001"/>
    <mesh name="wheel_fr_link" file="mobile/wheel_fr_link.stl" scale="0.001 0.001 0.001"/>
    <mesh name="wheel_rl_link" file="mobile/wheel_rl_link.stl" scale="0.001 0.001 0.001"/>
    <mesh name="wheel_rr_link" file="mobile/wheel_rr_link.stl" scale="0.001 0.001 0.001"/>
    <mesh name="lift_stage_1_link" file="mobile/lift_stage_1_link.stl" scale="0.001 0.001 0.001"/>
    <mesh name="lift_stage_2_link" file="mobile/lift_stage_2_link.stl" scale="0.001 0.001 0.001"/>
    <mesh name="top_plate_link" file="mobile/top_plate_link.stl" scale="0.001 0.001 0.001"/>
    <mesh name="front_camera_link" file="mobile/front_camera_link.stl" scale="0.001 0.001 0.001"/>
    <mesh name="colored_base_link_silver_trim" file="right_arm/visual/colored_base_link_silver_trim.stl"/>
    <mesh name="colored_base_link_hardware_black_no_plate" file="right_arm/visual/colored_base_link_hardware_black_no_plate.stl"/>
    <mesh name="colored_base_link_matte_black_no_plate" file="right_arm/visual/colored_base_link_matte_black_no_plate.stl"/>
    <mesh name="base_link_no_plate" file="right_arm/collision/base_link_no_plate.stl"/>
    <mesh name="colored_link1_matte_black" file="right_arm/visual/colored_link1_matte_black.stl"/>
    <mesh name="colored_link1_hardware_black" file="right_arm/visual/colored_link1_hardware_black.stl"/>
    <mesh name="colored_link1_anodized_grey" file="right_arm/visual/colored_link1_anodized_grey.stl"/>
    <mesh name="link1" file="right_arm/collision/link1.STL"/>
    <mesh name="colored_link2_seeed_yellow" file="right_arm/visual/colored_link2_seeed_yellow.stl"/>
    <mesh name="colored_link2_matte_black" file="right_arm/visual/colored_link2_matte_black.stl"/>
    <mesh name="colored_link2_hardware_black" file="right_arm/visual/colored_link2_hardware_black.stl"/>
    <mesh name="colored_link2_anodized_grey" file="right_arm/visual/colored_link2_anodized_grey.stl"/>
    <mesh name="link2" file="right_arm/collision/link2.STL"/>
    <mesh name="colored_link3_seeed_yellow" file="right_arm/visual/colored_link3_seeed_yellow.stl"/>
    <mesh name="colored_link3_matte_black" file="right_arm/visual/colored_link3_matte_black.stl"/>
    <mesh name="colored_link3_hardware_black" file="right_arm/visual/colored_link3_hardware_black.stl"/>
    <mesh name="colored_link3_anodized_grey" file="right_arm/visual/colored_link3_anodized_grey.stl"/>
    <mesh name="link3" file="right_arm/collision/link3.STL"/>
    <mesh name="colored_link4_seeed_yellow" file="right_arm/visual/colored_link4_seeed_yellow.stl"/>
    <mesh name="colored_link4_matte_black" file="right_arm/visual/colored_link4_matte_black.stl"/>
    <mesh name="colored_link4_hardware_black" file="right_arm/visual/colored_link4_hardware_black.stl"/>
    <mesh name="colored_link4_anodized_grey" file="right_arm/visual/colored_link4_anodized_grey.stl"/>
    <mesh name="link4" file="right_arm/collision/link4.STL"/>
    <mesh name="colored_link5_matte_black" file="right_arm/visual/colored_link5_matte_black.stl"/>
    <mesh name="colored_link5_hardware_black" file="right_arm/visual/colored_link5_hardware_black.stl"/>
    <mesh name="colored_link5_anodized_grey" file="right_arm/visual/colored_link5_anodized_grey.stl"/>
    <mesh name="link5" file="right_arm/collision/link5.STL"/>
    <mesh name="colored_link6_matte_black" file="right_arm/visual/colored_link6_matte_black.stl"/>
    <mesh name="colored_link6_hardware_black" file="right_arm/visual/colored_link6_hardware_black.stl"/>
    <mesh name="link6" file="right_arm/collision/link6.STL"/>
    <mesh name="colored_gripper_base_seeed_yellow" file="right_arm/visual/colored_gripper_base_seeed_yellow.stl"/>
    <mesh name="colored_gripper_base_hardware_black" file="right_arm/visual/colored_gripper_base_hardware_black.stl"/>
    <mesh name="colored_gripper_base_metal" file="right_arm/visual/colored_gripper_base_metal.stl"/>
    <mesh name="gripper_base" file="right_arm/collision/gripper_base.stl"/>
    <mesh name="colored_left_finger_finger_black" file="right_arm/visual/colored_left_finger_finger_black.stl"/>
    <mesh name="colored_left_finger_carriage_grey" file="right_arm/shared/colored_left_finger_carriage_grey.stl"/>
    <mesh name="colored_left_finger_travel_stop_yellow" file="right_arm/shared/colored_left_finger_travel_stop_yellow.stl"/>
    <mesh name="colored_left_finger_rack_metal" file="right_arm/visual/colored_left_finger_rack_metal.stl"/>
    <mesh name="left_finger" file="right_arm/collision/left_finger.stl"/>
    <mesh name="colored_right_finger_finger_black" file="right_arm/visual/colored_right_finger_finger_black.stl"/>
    <mesh name="colored_right_finger_carriage_grey" file="right_arm/shared/colored_right_finger_carriage_grey.stl"/>
    <mesh name="colored_right_finger_travel_stop_yellow" file="right_arm/shared/colored_right_finger_travel_stop_yellow.stl"/>
    <mesh name="colored_right_finger_rack_metal" file="right_arm/visual/colored_right_finger_rack_metal.stl"/>
    <mesh name="right_finger" file="right_arm/collision/right_finger.stl"/>
    <mesh name="D435_Gemini2_Mount" file="right_arm/camera/mounts/D435_Gemini2_Mount.stl" scale="0.001 0.001 0.001"/>
    <mesh name="d435_0" content_type="model/stl" file="right_arm/camera/realsense/d435_0.stl"/>
    <mesh name="d435_1" file="right_arm/camera/realsense/d435_1.stl"/>
  </asset>

  <worldbody>
    <geom name="floor" size="10 10 0.05" type="plane" conaffinity="2" material="grid"/>
    <light pos="1 -1 3" dir="-0.276172 0.276172 -0.920575" type="directional"/>
    <body name="base_link" pos="0 0 -0.02">
      <inertial pos="-0.00127648 -4.25225e-06 0.268718" quat="0.704995 0.704922 -0.055247 0.0549063" mass="13.551" diaginertia="0.304432 0.263841 0.252511"/>
      <joint name="base_free" type="free"/>
      <geom pos="0 0 0.02" quat="1 0 0 0" type="mesh" contype="0" conaffinity="0" group="2" density="0" rgba="0.62 0.64 0.68 1" mesh="base_link"/>
      <geom pos="0 0 0.02" quat="1 0 0 0" type="mesh" contype="0" conaffinity="0" group="3" rgba="1 0.4 0.2 0.3" mesh="base_link"/>
      <body name="steering_fl_link" pos="0.0911 0.13605 0.189">
        <inertial pos="5.92672e-10 0.000218125 -0.0491333" quat="0.999943 -0.0107172 0 0" mass="0.2725" diaginertia="0.000368866 0.000312952 0.000255327"/>
        <joint name="steering_fl_joint" pos="0 0 0" axis="0 0 1" limited="true" range="-3.31613 3.31613" armature="0.006" damping="0.05"/>
        <geom pos="-0.0911 -0.13605 -0.169" type="mesh" contype="0" conaffinity="0" group="2" density="0" rgba="0.62 0.64 0.68 1" mesh="steering_fl_link"/>
        <geom pos="-0.0911 -0.13605 -0.169" type="mesh" contype="0" conaffinity="0" group="3" rgba="1 0.4 0.2 0.3" mesh="steering_fl_link"/>
        <body name="wheel_fl_link" pos="0 0 -0.1165">
          <inertial pos="-4.4306e-06 -8.15918e-06 -9.94781e-06" quat="0.691273 0.148485 0.148799 0.691341" mass="1.5" diaginertia="0.00178836 0.00116475 0.00116435"/>
          <joint name="drive_fl_joint" pos="0 0 0" axis="0 1 0" armature="0.002" damping="0.01"/>
          <geom pos="-0.0911 -0.13605 -0.0525" quat="1 0 0 0" type="mesh" contype="0" conaffinity="0" group="2" density="0" rgba="0.62 0.64 0.68 1" mesh="wheel_fl_link"/>
          <geom pos="-0.0911 -0.13605 -0.0525" quat="1 0 0 0" type="mesh" contype="0" conaffinity="0" group="3" rgba="1 0.4 0.2 0.3" mesh="wheel_fl_link"/>
          <geom name="tire_fl" size="0.0525 0.02" quat="0.707107 -0.707107 0 0" type="cylinder" contype="2" group="3" rgba="0.2 0.2 0.2 0.4"/>
        </body>
      </body>
      <body name="steering_fr_link" pos="0.0911 -0.13605 0.189">
        <inertial pos="6.34429e-10 0.000218126 -0.0491333" quat="0.999943 -0.0107171 0 0" mass="0.2725" diaginertia="0.000368866 0.000312952 0.000255327"/>
        <joint name="steering_fr_joint" pos="0 0 0" axis="0 0 1" limited="true" range="-3.31613 3.31613" armature="0.006" damping="0.05"/>
        <geom pos="-0.0911 0.13605 -0.169" type="mesh" contype="0" conaffinity="0" group="2" density="0" rgba="0.62 0.64 0.68 1" mesh="steering_fr_link"/>
        <geom pos="-0.0911 0.13605 -0.169" type="mesh" contype="0" conaffinity="0" group="3" rgba="1 0.4 0.2 0.3" mesh="steering_fr_link"/>
        <body name="wheel_fr_link" pos="0 0 -0.1165">
          <inertial pos="-4.4306e-06 -8.16802e-06 -9.94781e-06" quat="0.691273 0.148485 0.148799 0.691341" mass="1.5" diaginertia="0.00178836 0.00116475 0.00116435"/>
          <joint name="drive_fr_joint" pos="0 0 0" axis="0 1 0" armature="0.002" damping="0.01"/>
          <geom pos="-0.0911 0.13605 -0.0525" quat="1 0 0 0" type="mesh" contype="0" conaffinity="0" group="2" density="0" rgba="0.62 0.64 0.68 1" mesh="wheel_fr_link"/>
          <geom pos="-0.0911 0.13605 -0.0525" quat="1 0 0 0" type="mesh" contype="0" conaffinity="0" group="3" rgba="1 0.4 0.2 0.3" mesh="wheel_fr_link"/>
          <geom name="tire_fr" size="0.0525 0.02" quat="0.707107 -0.707107 0 0" type="cylinder" contype="2" group="3" rgba="0.2 0.2 0.2 0.4"/>
        </body>
      </body>
      <body name="steering_rl_link" pos="-0.0911 0.13605 0.189">
        <inertial pos="1.37201e-09 0.000218125 -0.0491333" quat="0.999943 -0.0107172 0 0" mass="0.2725" diaginertia="0.000368866 0.000312952 0.000255327"/>
        <joint name="steering_rl_joint" pos="0 0 0" axis="0 0 1" limited="true" range="-3.31613 3.31613" armature="0.006" damping="0.05"/>
        <geom pos="0.0911 -0.13605 -0.169" type="mesh" contype="0" conaffinity="0" group="2" density="0" rgba="0.62 0.64 0.68 1" mesh="steering_rl_link"/>
        <geom pos="0.0911 -0.13605 -0.169" type="mesh" contype="0" conaffinity="0" group="3" rgba="1 0.4 0.2 0.3" mesh="steering_rl_link"/>
        <body name="wheel_rl_link" pos="0 0 -0.1165">
          <inertial pos="-4.43093e-06 -8.15911e-06 -9.9478e-06" quat="0.691273 0.148485 0.148799 0.691341" mass="1.5" diaginertia="0.00178836 0.00116475 0.00116435"/>
          <joint name="drive_rl_joint" pos="0 0 0" axis="0 1 0" armature="0.002" damping="0.01"/>
          <geom pos="0.0911 -0.13605 -0.0525" quat="1 0 0 0" type="mesh" contype="0" conaffinity="0" group="2" density="0" rgba="0.62 0.64 0.68 1" mesh="wheel_rl_link"/>
          <geom pos="0.0911 -0.13605 -0.0525" quat="1 0 0 0" type="mesh" contype="0" conaffinity="0" group="3" rgba="1 0.4 0.2 0.3" mesh="wheel_rl_link"/>
          <geom name="tire_rl" size="0.0525 0.02" quat="0.707107 -0.707107 0 0" type="cylinder" contype="2" group="3" rgba="0.2 0.2 0.2 0.4"/>
        </body>
      </body>
      <body name="steering_rr_link" pos="-0.0911 -0.13605 0.189">
        <inertial pos="-5.38792e-06 0.000219937 -0.0491332" quat="0.999927 -0.0118551 -0.00212323 -9.53847e-05" mass="0.2725" diaginertia="0.000368876 0.00031296 0.000255311"/>
        <joint name="steering_rr_joint" pos="0 0 0" axis="0 0 1" limited="true" range="-3.31613 3.31613" armature="0.006" damping="0.05"/>
        <geom pos="0.0911 0.13605 -0.169" type="mesh" contype="0" conaffinity="0" group="2" density="0" rgba="0.62 0.64 0.68 1" mesh="steering_rr_link"/>
        <geom pos="0.0911 0.13605 -0.169" type="mesh" contype="0" conaffinity="0" group="3" rgba="1 0.4 0.2 0.3" mesh="steering_rr_link"/>
        <body name="wheel_rr_link" pos="0 0 -0.1165">
          <inertial pos="-4.43093e-06 -8.16795e-06 -9.9478e-06" quat="0.691273 0.148485 0.148799 0.691341" mass="1.5" diaginertia="0.00178836 0.00116475 0.00116435"/>
          <joint name="drive_rr_joint" pos="0 0 0" axis="0 1 0" armature="0.002" damping="0.01"/>
          <geom pos="0.0911 0.13605 -0.0525" quat="1 0 0 0" type="mesh" contype="0" conaffinity="0" group="2" density="0" rgba="0.62 0.64 0.68 1" mesh="wheel_rr_link"/>
          <geom pos="0.0911 0.13605 -0.0525" quat="1 0 0 0" type="mesh" contype="0" conaffinity="0" group="3" rgba="1 0.4 0.2 0.3" mesh="wheel_rr_link"/>
          <geom name="tire_rr" size="0.0525 0.02" quat="0.707107 -0.707107 0 0" type="cylinder" contype="2" group="3" rgba="0.2 0.2 0.2 0.4"/>
        </body>
      </body>
      <body name="lift_stage_1_link" pos="-0.02526 0 0.31918" gravcomp="1">
        <inertial pos="2.87949e-10 0 0.175" mass="1.2" diaginertia="0.00863758 0.00822664 0.000860802"/>
        <joint name="lift_stage_1_joint" pos="0 0 0" axis="0 0 1" type="slide" range="0 0.325" actuatorfrcrange="-1000 1000"/>
        <geom pos="0.02526 0 -0.62418" type="mesh" contype="0" conaffinity="0" group="2" density="0" rgba="0.62 0.64 0.68 1" mesh="lift_stage_1_link"/>
        <geom pos="0.02526 0 -0.62418" type="mesh" contype="0" conaffinity="0" group="3" rgba="1 0.4 0.2 0.3" mesh="lift_stage_1_link"/>
        <body name="lift_stage_2_link" pos="0 0 0.025" gravcomp="1">
          <inertial pos="-3.64424e-10 0 0.173331" mass="1" diaginertia="0.00962043 0.00934183 0.000545098"/>
          <joint name="lift_stage_2_joint" pos="0 0 0" axis="0 0 1" type="slide" range="0 0.325" actuatorfrcrange="-1000 1000"/>
          <geom pos="0.02526 0 -0.97418" type="mesh" contype="0" conaffinity="0" group="2" density="0" rgba="0.62 0.64 0.68 1" mesh="lift_stage_2_link"/>
          <geom pos="0.02526 0 -0.97418" type="mesh" contype="0" conaffinity="0" group="3" rgba="1 0.4 0.2 0.3" mesh="lift_stage_2_link"/>
          <body name="top_plate_link" pos="0 0 0.347" gravcomp="1">
            <inertial pos="0.0143275 0.000728789 -0.00229961" quat="0.0120492 0.716898 -0.0132037 0.696949" mass="0.2562" diaginertia="0.00139661 0.000849723 0.000784851"/>
            <geom pos="0.02526 0 -1.32118" quat="1 0 0 0" type="mesh" contype="0" conaffinity="0" group="2" density="0" rgba="0.62 0.64 0.68 1" mesh="top_plate_link"/>
            <geom pos="0.02526 0 -1.32118" quat="1 0 0 0" type="mesh" contype="0" conaffinity="0" group="3" rgba="1 0.4 0.2 0.3" mesh="top_plate_link"/>
            <body name="front_camera_link" pos="0.204827 0 0.023869" gravcomp="1">
              <inertial pos="-0.0243726 0.00269808 -0.00032321" quat="0.394842 0.367435 -0.620123 0.569684" mass="0.1008" diaginertia="8.3416e-05 5.80763e-05 3.3331e-05"/>
              <geom pos="-0.179567 1.22e-06 -1.34505" quat="1 0 0 0" type="mesh" contype="0" conaffinity="0" group="2" density="0" rgba="0.62 0.64 0.68 1" mesh="front_camera_link"/>
              <geom pos="-0.179567 1.22e-06 -1.34505" quat="1 0 0 0" type="mesh" contype="0" conaffinity="0" group="3" rgba="1 0.4 0.2 0.3" mesh="front_camera_link"/>
              <camera name="front" pos="0 0 0" quat="-0.5 -0.5 0.5 0.5" fovy="70"/>
            </body>
            <body name="right_arm_base_link" pos="0.022 -0.0823513 -0.0473259" quat="0.92388 0.382683 0 0" gravcomp="1">
              <inertial pos="-9.73557e-07 -1.58042e-06 0.0505773" quat="0.49916 0.501151 -0.500891 0.498793" mass="0.436413" diaginertia="0.000537736 0.000444618 0.000429788"/>
              <geom name="right_arm_base_link_silver_trim" type="mesh" contype="0" conaffinity="0" group="2" density="0" rgba="0.878431 0.890196 0.87451 1" mesh="colored_base_link_silver_trim"/>
              <geom name="right_arm_base_link_hardware_black" type="mesh" contype="0" conaffinity="0" group="2" density="0" rgba="0.019608 0.027451 0.023529 1" mesh="colored_base_link_hardware_black_no_plate"/>
              <geom name="right_arm_base_link_matte_black" type="mesh" contype="0" conaffinity="0" group="2" density="0" rgba="0.066667 0.07451 0.070588 1" mesh="colored_base_link_matte_black_no_plate"/>
              <geom type="mesh" contype="0" conaffinity="0" group="3" rgba="1 0.4 0.2 0.3" mesh="base_link_no_plate"/>
              <body name="right_arm_link1" pos="-8.416e-05 0 0.08465" gravcomp="1">
                <inertial pos="0.000113615 -0.00061632 0.0236476" quat="0.672066 0.672066 0.219836 -0.219836" mass="0.1613" diaginertia="0.000272817 0.000213413 0.00015464"/>
                <joint name="right_arm_joint1" pos="0 0 0" axis="0 0 1" range="-2.8 2.8" actuatorfrcrange="-27 27" armature="0.02"/>
                <geom name="right_arm_link1_matte_black" type="mesh" contype="0" conaffinity="0" group="2" density="0" rgba="0.066667 0.07451 0.070588 1" mesh="colored_link1_matte_black"/>
                <geom name="right_arm_link1_hardware_black" type="mesh" contype="0" conaffinity="0" group="2" density="0" rgba="0.019608 0.027451 0.023529 1" mesh="colored_link1_hardware_black"/>
                <geom name="right_arm_link1_anodized_grey" type="mesh" contype="0" conaffinity="0" group="2" density="0" rgba="0.831373 0.847059 0.831373 1" mesh="colored_link1_anodized_grey"/>
                <geom type="mesh" contype="0" conaffinity="0" group="3" rgba="1 0.4 0.2 0.3" mesh="link1"/>
                <body name="right_arm_link2" pos="0.020084 0.031625 0.05555" quat="0.707105 -0.707108 0 0" gravcomp="1">
                  <inertial pos="-0.132256 -0.0030617 -0.0308307" quat="0.00176765 0.707354 0.00179466 0.706855" mass="1.3266" diaginertia="0.0128139 0.0125599 0.000733734"/>
                  <joint name="right_arm_joint2" pos="0 0 0" axis="0 0 -1" range="-3.14 0" actuatorfrcrange="-27 27" armature="0.02"/>
                  <geom name="right_arm_link2_seeed_yellow" type="mesh" contype="0" conaffinity="0" group="2" density="0" rgba="0.73 0.84 0.12 1" mesh="colored_link2_seeed_yellow"/>
                  <geom name="right_arm_link2_matte_black" type="mesh" contype="0" conaffinity="0" group="2" density="0" rgba="0.066667 0.07451 0.070588 1" mesh="colored_link2_matte_black"/>
                  <geom name="right_arm_link2_hardware_black" type="mesh" contype="0" conaffinity="0" group="2" density="0" rgba="0.019608 0.027451 0.023529 1" mesh="colored_link2_hardware_black"/>
                  <geom name="right_arm_link2_anodized_grey" type="mesh" contype="0" conaffinity="0" group="2" density="0" rgba="0.831373 0.847059 0.831373 1" mesh="colored_link2_anodized_grey"/>
                  <geom type="mesh" contype="0" conaffinity="0" group="3" rgba="1 0.4 0.2 0.3" mesh="link2"/>
                  <body name="right_arm_link3" pos="-0.264 0 0" gravcomp="1">
                    <inertial pos="0.12104 -0.0536211 -0.0310138" quat="-0.00138181 0.704593 0.00278372 0.709605" mass="0.8353" diaginertia="0.00648251 0.00632715 0.000467564"/>
                    <joint name="right_arm_joint3" pos="0 0 0" axis="0 0 1" range="-3.14 0" actuatorfrcrange="-27 27" armature="0.02"/>
                    <geom name="right_arm_link3_seeed_yellow" type="mesh" contype="0" conaffinity="0" group="2" density="0" rgba="0.73 0.84 0.12 1" mesh="colored_link3_seeed_yellow"/>
                    <geom name="right_arm_link3_matte_black" type="mesh" contype="0" conaffinity="0" group="2" density="0" rgba="0.066667 0.07451 0.070588 1" mesh="colored_link3_matte_black"/>
                    <geom name="right_arm_link3_hardware_black" type="mesh" contype="0" conaffinity="0" group="2" density="0" rgba="0.019608 0.027451 0.023529 1" mesh="colored_link3_hardware_black"/>
                    <geom name="right_arm_link3_anodized_grey" type="mesh" contype="0" conaffinity="0" group="2" density="0" rgba="0.831373 0.847059 0.831373 1" mesh="colored_link3_anodized_grey"/>
                    <geom type="mesh" contype="0" conaffinity="0" group="3" rgba="1 0.4 0.2 0.3" mesh="link3"/>
                    <body name="right_arm_link4" pos="0.2426 -0.054 -0.001625" gravcomp="1">
                      <inertial pos="0.0608201 -0.0511712 -0.0302995" quat="0.619751 0.601248 0.365808 0.347267" mass="0.52" diaginertia="0.000889485 0.000667165 0.000323211"/>
                      <joint name="right_arm_joint4" pos="0 0 0" axis="0 0 1" range="-1.87 1.57" actuatorfrcrange="-7 7" armature="0.01"/>
                      <geom name="right_arm_link4_seeed_yellow" type="mesh" contype="0" conaffinity="0" group="2" density="0" rgba="0.066667 0.07451 0.070588 1" mesh="colored_link4_seeed_yellow"/>
                      <geom name="right_arm_link4_matte_black" type="mesh" contype="0" conaffinity="0" group="2" density="0" rgba="0.066667 0.07451 0.070588 1" mesh="colored_link4_matte_black"/>
                      <geom name="right_arm_link4_hardware_black" type="mesh" contype="0" conaffinity="0" group="2" density="0" rgba="0.019608 0.027451 0.023529 1" mesh="colored_link4_hardware_black"/>
                      <geom name="right_arm_link4_anodized_grey" type="mesh" contype="0" conaffinity="0" group="2" density="0" rgba="0.831373 0.847059 0.831373 1" mesh="colored_link4_anodized_grey"/>
                      <geom type="mesh" contype="0" conaffinity="0" group="3" rgba="1 0.4 0.2 0.3" mesh="link4"/>
                      <body name="right_arm_link5" pos="0.078308 -0.0375 -0.03" quat="0.707105 -0.707108 0 0" gravcomp="1">
                        <inertial pos="-0.00502802 1.73866e-06 0.0386233" quat="0.644154 0.196994 0.180566 0.716697" mass="0.383" diaginertia="0.000217429 0.000212237 0.000157335"/>
                        <joint name="right_arm_joint5" pos="0 0 0" axis="0 0 1" range="-1.57 1.57" actuatorfrcrange="-7 7" armature="0.01"/>
                        <geom name="right_arm_link5_matte_black" type="mesh" contype="0" conaffinity="0" group="2" density="0" rgba="0.066667 0.07451 0.070588 1" mesh="colored_link5_matte_black"/>
                        <geom name="right_arm_link5_hardware_black" type="mesh" contype="0" conaffinity="0" group="2" density="0" rgba="0.019608 0.027451 0.023529 1" mesh="colored_link5_hardware_black"/>
                        <geom name="right_arm_link5_anodized_grey" type="mesh" contype="0" conaffinity="0" group="2" density="0" rgba="0.831373 0.847059 0.831373 1" mesh="colored_link5_anodized_grey"/>
                        <geom type="mesh" contype="0" conaffinity="0" group="3" rgba="1 0.4 0.2 0.3" mesh="link5"/>
                        <body name="right_arm_link6" pos="0.028008 0 0.04" quat="0.707105 0 0.707108 0" gravcomp="1">
                          <inertial pos="3.76419e-06 -0.000100909 0.0253309" mass="0.3663" diaginertia="0.00015554 0.00015554 0.00013966"/>
                          <joint name="right_arm_joint6" pos="0 0 0" axis="0 0 1" range="-3.14 3.14" actuatorfrcrange="-7 7" armature="0.01"/>
                          <geom name="right_arm_link6_matte_black" type="mesh" contype="0" conaffinity="0" group="2" density="0" rgba="0.066667 0.07451 0.070588 1" mesh="colored_link6_matte_black"/>
                          <geom name="right_arm_link6_hardware_black" type="mesh" contype="0" conaffinity="0" group="2" density="0" rgba="0.019608 0.027451 0.023529 1" mesh="colored_link6_hardware_black"/>
                          <geom type="mesh" contype="0" conaffinity="0" group="3" rgba="1 0.4 0.2 0.3" mesh="link6"/>
                          <body name="right_arm_end_link" pos="0 0 0.15539" quat="3.27579e-05 0.707108 -3.27581e-05 0.707105" gravcomp="1">
                            <inertial pos="-0.0737654 -9.5081e-06 7.04328e-06" quat="0.504636 0.498456 -0.49563 0.501234" mass="0.5" diaginertia="0.000453574 0.000373537 0.000158259"/>
                            <geom name="right_arm_gripper_base_seeed_yellow" type="mesh" contype="0" conaffinity="0" group="2" density="0" rgba="0.725 0.835 0.118 1" mesh="colored_gripper_base_seeed_yellow"/>
                            <geom name="right_arm_gripper_base_hardware_black" type="mesh" contype="0" conaffinity="0" group="2" density="0" rgba="0.019608 0.027451 0.023529 1" mesh="colored_gripper_base_hardware_black"/>
                            <geom name="right_arm_gripper_base_metal" type="mesh" contype="0" conaffinity="0" group="2" density="0" rgba="0.831373 0.847059 0.831373 1" mesh="colored_gripper_base_metal"/>
                            <geom type="mesh" contype="0" conaffinity="0" group="3" rgba="1 0.4 0.2 0.3" mesh="gripper_base"/>
                            <body name="right_arm_finger_left_link" gravcomp="1">
                              <inertial pos="-0.065957 0.0133657 -0.00305287" quat="0.058009 0.613649 -0.17383 0.768019" mass="0.03" diaginertia="1.58942e-05 1.21832e-05 8.64682e-06"/>
                              <joint name="right_arm_finger_left" pos="0 0 0" axis="0 1 0" type="slide" range="0 0.05" actuatorfrcrange="-8 8" armature="0.001"/>
                              <geom name="right_arm_finger_left_body" type="mesh" contype="0" conaffinity="0" group="2" density="0" rgba="0.066667 0.07451 0.070588 1" mesh="colored_left_finger_finger_black"/>
                              <geom name="right_arm_finger_left_carriage" type="mesh" contype="0" conaffinity="0" group="2" density="0" rgba="0.239 0.278 0.271 1" mesh="colored_left_finger_carriage_grey"/>
                              <geom name="right_arm_finger_left_travel_stop" type="mesh" contype="0" conaffinity="0" group="2" density="0" rgba="0.725 0.835 0.118 1" mesh="colored_left_finger_travel_stop_yellow"/>
                              <geom name="right_arm_finger_left_crossed_rack" type="mesh" contype="0" conaffinity="0" group="2" density="0" rgba="0.831373 0.847059 0.831373 1" mesh="colored_left_finger_rack_metal"/>
                              <geom type="mesh" contype="0" conaffinity="0" group="3" rgba="1 0.4 0.2 0.3" mesh="left_finger"/>
                            </body>
                            <body name="right_arm_finger_right_link" gravcomp="1">
                              <inertial pos="-0.0659324 -0.013426 0.00308921" quat="-0.17323 0.768101 0.0595682 0.613567" mass="0.03" diaginertia="1.58381e-05 1.21475e-05 8.6429e-06"/>
                              <joint name="right_arm_finger_right" pos="0 0 0" axis="0 1 0" type="slide" range="-0.05 0" actuatorfrcrange="-8 8"/>
                              <geom name="right_arm_finger_right_body" type="mesh" contype="0" conaffinity="0" group="2" density="0" rgba="0.066667 0.07451 0.070588 1" mesh="colored_right_finger_finger_black"/>
                              <geom name="right_arm_finger_right_carriage" type="mesh" contype="0" conaffinity="0" group="2" density="0" rgba="0.239 0.278 0.271 1" mesh="colored_right_finger_carriage_grey"/>
                              <geom name="right_arm_finger_right_travel_stop" type="mesh" contype="0" conaffinity="0" group="2" density="0" rgba="0.725 0.835 0.118 1" mesh="colored_right_finger_travel_stop_yellow"/>
                              <geom name="right_arm_finger_right_crossed_rack" type="mesh" contype="0" conaffinity="0" group="2" density="0" rgba="0.831373 0.847059 0.831373 1" mesh="colored_right_finger_rack_metal"/>
                              <geom type="mesh" contype="0" conaffinity="0" group="3" rgba="1 0.4 0.2 0.3" mesh="right_finger"/>
                            </body>
                            <body name="right_arm_wrist_gripper_end" pos="0.01082 0 -3.97441e-08" quat="1 5e-05 3.67321e-06 -1.34924e-11" gravcomp="1">
                              <body name="right_arm_wrist_camera_mount_link" pos="-0.1201 0.0003 0.045" quat="0.502385 0.507205 0.498693 0.491587" gravcomp="1">
                                <inertial pos="0.00168106 0.0392656 0.00129679" quat="0.610746 0.352812 -0.395003 0.58863" mass="0.0461" diaginertia="5.49664e-05 3.83665e-05 2.20609e-05"/>
                                <geom type="mesh" contype="0" conaffinity="0" group="2" density="0" rgba="0.62 0.64 0.68 1" mesh="D435_Gemini2_Mount"/>
                                <body name="right_arm_wrist_camera_bottom_screw_frame" pos="-0.0003 0.0445 -0.0095" quat="0.605908 -0.355065 -0.353109 -0.618158" gravcomp="1">
                                  <body name="right_arm_wrist_camera_link" pos="0.0106 0.0175 0.0125" gravcomp="1">
                                    <inertial pos="0 0 0" quat="0.707107 0.707107 0 0" mass="0.072" diaginertia="0.00388124 0.00387926 0.00049894"/>
                                    <geom pos="0.0043 -0.0175 0" quat="0.5 0.5 0.5 0.5" type="mesh" contype="0" conaffinity="0" group="2" density="0" rgba="0.62 0.64 0.68 1" mesh="d435_0"/>
                                    <geom pos="0.0043 -0.0175 0" quat="0.5 0.5 0.5 0.5" type="mesh" contype="0" conaffinity="0" group="2" density="0" rgba="0.62 0.64 0.68 1" mesh="d435_1"/>
                                    <geom size="0.012525 0.045 0.0125" pos="0 -0.0175 0" type="box" contype="0" conaffinity="0" group="3" rgba="1 0.4 0.2 0.3"/>
                                    <body name="right_arm_wrist_camera_depth_frame" gravcomp="1">
                                      <body name="right_arm_wrist_camera_depth_optical_frame" quat="0.5 -0.5 0.5 -0.5" gravcomp="1"/>
                                    </body>
                                    <body name="right_arm_wrist_camera_infra1_frame" gravcomp="1">
                                      <body name="right_arm_wrist_camera_infra1_optical_frame" quat="0.5 -0.5 0.5 -0.5" gravcomp="1"/>
                                    </body>
                                    <body name="right_arm_wrist_camera_infra2_frame" pos="0 -0.05 0" gravcomp="1">
                                      <body name="right_arm_wrist_camera_infra2_optical_frame" quat="0.5 -0.5 0.5 -0.5" gravcomp="1"/>
                                    </body>
                                    <body name="right_arm_wrist_camera_color_frame" pos="0 0.015 0" gravcomp="1">
                                      <body name="right_arm_wrist_camera_color_optical_frame" quat="0.5 -0.5 0.5 -0.5" gravcomp="1">
                                        <camera name="wrist_color" pos="0 0 0" quat="0 1 0 0" fovy="60"/>
                                      </body>
                                    </body>
                                    <body name="right_arm_wrist_camera_accel_frame" pos="-0.01174 -0.00552 0.0051" gravcomp="1">
                                      <body name="right_arm_wrist_camera_accel_optical_frame" quat="0.5 -0.5 0.5 -0.5" gravcomp="1"/>
                                    </body>
                                    <body name="right_arm_wrist_camera_gyro_frame" pos="-0.01174 -0.00552 0.0051" gravcomp="1">
                                      <body name="right_arm_wrist_camera_gyro_optical_frame" quat="0.5 -0.5 0.5 -0.5" gravcomp="1"/>
                                    </body>
                                  </body>
                                </body>
                              </body>
                            </body>
                          </body>
                        </body>
                      </body>
                    </body>
                  </body>
                </body>
              </body>
            </body>
          </body>
        </body>
      </body>
    </body>
  </worldbody>

  <equality>
    <joint joint1="lift_stage_2_joint" joint2="lift_stage_1_joint" polycoef="0 1 0 0 0"/>
    <joint joint1="right_arm_finger_right" joint2="right_arm_finger_left" polycoef="0 -1 0 0 0"/>
  </equality>

  <actuator>
    <general name="steering_fl_joint" joint="steering_fl_joint" ctrllimited="true" ctrlrange="-17 17"/>
    <general name="drive_fl_joint" joint="drive_fl_joint" ctrllimited="true" ctrlrange="-6 6"/>
    <general name="steering_fr_joint" joint="steering_fr_joint" ctrllimited="true" ctrlrange="-17 17"/>
    <general name="drive_fr_joint" joint="drive_fr_joint" ctrllimited="true" ctrlrange="-6 6"/>
    <general name="steering_rl_joint" joint="steering_rl_joint" ctrllimited="true" ctrlrange="-17 17"/>
    <general name="drive_rl_joint" joint="drive_rl_joint" ctrllimited="true" ctrlrange="-6 6"/>
    <general name="steering_rr_joint" joint="steering_rr_joint" ctrllimited="true" ctrlrange="-17 17"/>
    <general name="drive_rr_joint" joint="drive_rr_joint" ctrllimited="true" ctrlrange="-6 6"/>
    <general name="lift_stage_1_joint" joint="lift_stage_1_joint" ctrlrange="0 0.325" biastype="affine" gainprm="3000" biasprm="0 -3000 1"/>
    <general name="right_arm_joint1" joint="right_arm_joint1" ctrlrange="-2.8 2.8" biastype="affine" gainprm="200" biasprm="0 -200 1"/>
    <general name="right_arm_joint2" joint="right_arm_joint2" ctrlrange="-3.14 0" biastype="affine" gainprm="200" biasprm="0 -200 1"/>
    <general name="right_arm_joint3" joint="right_arm_joint3" ctrlrange="-3.14 0" biastype="affine" gainprm="200" biasprm="0 -200 1"/>
    <general name="right_arm_joint4" joint="right_arm_joint4" ctrlrange="-1.87 1.57" biastype="affine" gainprm="30" biasprm="0 -30 1"/>
    <general name="right_arm_joint5" joint="right_arm_joint5" ctrlrange="-1.57 1.57" biastype="affine" gainprm="30" biasprm="0 -30 1"/>
    <general name="right_arm_joint6" joint="right_arm_joint6" ctrlrange="-3.14 3.14" biastype="affine" gainprm="30" biasprm="0 -30 1"/>
    <general name="right_arm_finger_left" joint="right_arm_finger_left" ctrlrange="0 0.05" biastype="affine" gainprm="50" biasprm="0 -50 1"/>
  </actuator>

  <keyframe>
    <key name="home" qpos="0 0 -0.017 1 0 0 0 0 0 0 0 0 0 0 0 0 0 0 -2 -1.2 -1 0 0 0.035 -0.035" ctrl="0 0 0 0 0 0 0 0 0 0 -2 -1.2 -1 0 0 0.035"/>
  </keyframe>
</mujoco>
