YunBeeeen/Capstone/capstone_ws/src/description/source/mobile-original.urdf

<?xml version="1.0"?>
<robot name="mobile_robot">
  <link name="world"/>

  <link name="base_link">
      <visual>
        <origin xyz="0.000000000 0.000000000 0.020000000" rpy="0 0 0"/>
        <geometry><mesh filename="package://mobile_robot_description/meshes/base_link.stl" scale="0.001 0.001 0.001"/></geometry>
      </visual>
      <collision>
        <origin xyz="0.000000000 0.000000000 0.020000000" rpy="0 0 0"/>
        <geometry><mesh filename="package://mobile_robot_description/meshes/base_link.stl" scale="0.001 0.001 0.001"/></geometry>
      </collision>
  </link>

  <link name="steering_fl_link">
      <visual>
        <origin xyz="-0.091100000 -0.136050000 -0.169000000" rpy="0 0 0"/>
        <geometry><mesh filename="package://mobile_robot_description/meshes/steering_fl_link.stl" scale="0.001 0.001 0.001"/></geometry>
      </visual>
      <collision>
        <origin xyz="-0.091100000 -0.136050000 -0.169000000" rpy="0 0 0"/>
        <geometry><mesh filename="package://mobile_robot_description/meshes/steering_fl_link.stl" scale="0.001 0.001 0.001"/></geometry>
      </collision>
  </link>

  <link name="steering_fr_link">
      <visual>
        <origin xyz="-0.091100000 0.136050000 -0.169000000" rpy="0 0 0"/>
        <geometry><mesh filename="package://mobile_robot_description/meshes/steering_fr_link.stl" scale="0.001 0.001 0.001"/></geometry>
      </visual>
      <collision>
        <origin xyz="-0.091100000 0.136050000 -0.169000000" rpy="0 0 0"/>
        <geometry><mesh filename="package://mobile_robot_description/meshes/steering_fr_link.stl" scale="0.001 0.001 0.001"/></geometry>
      </collision>
  </link>

  <link name="steering_rl_link">
      <visual>
        <origin xyz="0.091100000 -0.136050000 -0.169000000" rpy="0 0 0"/>
        <geometry><mesh filename="package://mobile_robot_description/meshes/steering_rl_link.stl" scale="0.001 0.001 0.001"/></geometry>
      </visual>
      <collision>
        <origin xyz="0.091100000 -0.136050000 -0.169000000" rpy="0 0 0"/>
        <geometry><mesh filename="package://mobile_robot_description/meshes/steering_rl_link.stl" scale="0.001 0.001 0.001"/></geometry>
      </collision>
  </link>

  <link name="steering_rr_link">
      <visual>
        <origin xyz="0.091100000 0.136050000 -0.169000000" rpy="0 0 0"/>
        <geometry><mesh filename="package://mobile_robot_description/meshes/steering_rr_link.stl" scale="0.001 0.001 0.001"/></geometry>
      </visual>
      <collision>
        <origin xyz="0.091100000 0.136050000 -0.169000000" rpy="0 0 0"/>
        <geometry><mesh filename="package://mobile_robot_description/meshes/steering_rr_link.stl" scale="0.001 0.001 0.001"/></geometry>
      </collision>
  </link>

  <link name="wheel_fl_link">
      <visual>
        <origin xyz="-0.091100000 -0.136050000 -0.052500000" rpy="0 0 0"/>
        <geometry><mesh filename="package://mobile_robot_description/meshes/wheel_fl_link.stl" scale="0.001 0.001 0.001"/></geometry>
      </visual>
      <collision>
        <origin xyz="-0.091100000 -0.136050000 -0.052500000" rpy="0 0 0"/>
        <geometry><mesh filename="package://mobile_robot_description/meshes/wheel_fl_link.stl" scale="0.001 0.001 0.001"/></geometry>
      </collision>
  </link>

  <link name="wheel_fr_link">
      <visual>
        <origin xyz="-0.091100000 0.136050000 -0.052500000" rpy="0 0 0"/>
        <geometry><mesh filename="package://mobile_robot_description/meshes/wheel_fr_link.stl" scale="0.001 0.001 0.001"/></geometry>
      </visual>
      <collision>
        <origin xyz="-0.091100000 0.136050000 -0.052500000" rpy="0 0 0"/>
        <geometry><mesh filename="package://mobile_robot_description/meshes/wheel_fr_link.stl" scale="0.001 0.001 0.001"/></geometry>
      </collision>
  </link>

  <link name="wheel_rl_link">
      <visual>
        <origin xyz="0.091100000 -0.136050000 -0.052500000" rpy="0 0 0"/>
        <geometry><mesh filename="package://mobile_robot_description/meshes/wheel_rl_link.stl" scale="0.001 0.001 0.001"/></geometry>
      </visual>
      <collision>
        <origin xyz="0.091100000 -0.136050000 -0.052500000" rpy="0 0 0"/>
        <geometry><mesh filename="package://mobile_robot_description/meshes/wheel_rl_link.stl" scale="0.001 0.001 0.001"/></geometry>
      </collision>
  </link>

  <link name="wheel_rr_link">
      <visual>
        <origin xyz="0.091100000 0.136050000 -0.052500000" rpy="0 0 0"/>
        <geometry><mesh filename="package://mobile_robot_description/meshes/wheel_rr_link.stl" scale="0.001 0.001 0.001"/></geometry>
      </visual>
      <collision>
        <origin xyz="0.091100000 0.136050000 -0.052500000" rpy="0 0 0"/>
        <geometry><mesh filename="package://mobile_robot_description/meshes/wheel_rr_link.stl" scale="0.001 0.001 0.001"/></geometry>
      </collision>
  </link>

  <link name="lift_stage_1_link">
      <visual>
        <origin xyz="0.025260000 0.000000000 -0.624180000" rpy="0 0 0"/>
        <geometry><mesh filename="package://mobile_robot_description/meshes/lift_stage_1_link.stl" scale="0.001 0.001 0.001"/></geometry>
      </visual>
      <collision>
        <origin xyz="0.025260000 0.000000000 -0.624180000" rpy="0 0 0"/>
        <geometry><mesh filename="package://mobile_robot_description/meshes/lift_stage_1_link.stl" scale="0.001 0.001 0.001"/></geometry>
      </collision>
  </link>

  <link name="lift_stage_2_link">
      <visual>
        <origin xyz="0.025260000 0.000000000 -0.974180000" rpy="0 0 0"/>
        <geometry><mesh filename="package://mobile_robot_description/meshes/lift_stage_2_link.stl" scale="0.001 0.001 0.001"/></geometry>
      </visual>
      <collision>
        <origin xyz="0.025260000 0.000000000 -0.974180000" rpy="0 0 0"/>
        <geometry><mesh filename="package://mobile_robot_description/meshes/lift_stage_2_link.stl" scale="0.001 0.001 0.001"/></geometry>
      </collision>
  </link>

  <link name="top_plate_link">
      <visual>
        <origin xyz="0.025260000 0.000000000 -1.321180000" rpy="0 0 0"/>
        <geometry><mesh filename="package://mobile_robot_description/meshes/top_plate_link.stl" scale="0.001 0.001 0.001"/></geometry>
      </visual>
      <collision>
        <origin xyz="0.025260000 0.000000000 -1.321180000" rpy="0 0 0"/>
        <geometry><mesh filename="package://mobile_robot_description/meshes/top_plate_link.stl" scale="0.001 0.001 0.001"/></geometry>
      </collision>
  </link>

  <link name="front_camera_link">
      <visual>
        <origin xyz="-0.179567112 0.000001220 -1.345048987" rpy="0 0 0"/>
        <geometry><mesh filename="package://mobile_robot_description/meshes/front_camera_link.stl" scale="0.001 0.001 0.001"/></geometry>
      </visual>
      <collision>
        <origin xyz="-0.179567112 0.000001220 -1.345048987" rpy="0 0 0"/>
        <geometry><mesh filename="package://mobile_robot_description/meshes/front_camera_link.stl" scale="0.001 0.001 0.001"/></geometry>
      </collision>
  </link>

  <joint name="world_to_base" type="fixed">
    <parent link="world"/><child link="base_link"/>
    <origin xyz="0 0 -0.020" rpy="0 0 0"/>
  </joint>

  <joint name="steering_fl_joint" type="continuous">
    <parent link="base_link"/><child link="steering_fl_link"/>
    <origin xyz="0.09110 0.13605 0.189" rpy="0 0 0"/>
    <axis xyz="0 0 1"/>
  </joint>

  <joint name="drive_fl_joint" type="continuous">
    <parent link="steering_fl_link"/><child link="wheel_fl_link"/>
    <origin xyz="0 0 -0.1165" rpy="0 0 0"/>
    <axis xyz="0 1 0"/>
  </joint>

  <joint name="steering_fr_joint" type="continuous">
    <parent link="base_link"/><child link="steering_fr_link"/>
    <origin xyz="0.09110 -0.13605 0.189" rpy="0 0 0"/>
    <axis xyz="0 0 1"/>
  </joint>

  <joint name="drive_fr_joint" type="continuous">
    <parent link="steering_fr_link"/><child link="wheel_fr_link"/>
    <origin xyz="0 0 -0.1165" rpy="0 0 0"/>
    <axis xyz="0 1 0"/>
  </joint>

  <joint name="steering_rl_joint" type="continuous">
    <parent link="base_link"/><child link="steering_rl_link"/>
    <origin xyz="-0.09110 0.13605 0.189" rpy="0 0 0"/>
    <axis xyz="0 0 1"/>
  </joint>

  <joint name="drive_rl_joint" type="continuous">
    <parent link="steering_rl_link"/><child link="wheel_rl_link"/>
    <origin xyz="0 0 -0.1165" rpy="0 0 0"/>
    <axis xyz="0 1 0"/>
  </joint>

  <joint name="steering_rr_joint" type="continuous">
    <parent link="base_link"/><child link="steering_rr_link"/>
    <origin xyz="-0.09110 -0.13605 0.189" rpy="0 0 0"/>
    <axis xyz="0 0 1"/>
  </joint>

  <joint name="drive_rr_joint" type="continuous">
    <parent link="steering_rr_link"/><child link="wheel_rr_link"/>
    <origin xyz="0 0 -0.1165" rpy="0 0 0"/>
    <axis xyz="0 1 0"/>
  </joint>

  <joint name="lift_stage_1_joint" type="prismatic">
    <parent link="base_link"/><child link="lift_stage_1_link"/>
    <origin xyz="-0.02526 0 0.64418" rpy="0 0 0"/>
    <axis xyz="0 0 1"/>
    <limit lower="0" upper="0.35" effort="1000" velocity="0.1"/>
  </joint>

  <joint name="lift_stage_2_joint" type="prismatic">
    <parent link="lift_stage_1_link"/><child link="lift_stage_2_link"/>
    <origin xyz="0 0 0.350" rpy="0 0 0"/>
    <axis xyz="0 0 1"/>
    <limit lower="0" upper="0.347" effort="1000" velocity="0.1"/>
  </joint>

  <joint name="top_plate_joint" type="fixed">
    <parent link="lift_stage_2_link"/><child link="top_plate_link"/>
    <origin xyz="0 0 0.347" rpy="0 0 0"/>
  </joint>

  <joint name="front_camera_joint" type="fixed">
    <parent link="top_plate_link"/><child link="front_camera_link"/>
    <origin xyz="0.204827112 0 0.023868987" rpy="0 0 0"/>
  </joint>
</robot>
