YunBeeeen/Capstone/(commit log)

2026-11-08 모바일 휴머노이드 하위 제어 · 로봇 모델 · MuJoCo 시뮬 초기 업로드
    - 구동: XDrive(ODrive v3.6) 브링업 도구 + wheel_can_bridge (C++, CANSimple)
    - 조향: RobStride 02 도구 + steer_can_bridge (C++, MIT 위치 제어)
    - swerve_controller: KSRC 펌웨어 IK 포팅, 정지 후 조향·조향 속도 제한, Python 바인딩
    - 로봇 모델(이동로봇 + 오른팔 + D435i) URDF/MJCF, MuJoCo 시뮬, RViz
    - 텔레옵: 게임패드 / 화면 가상 패드
    - CAN 어댑터 이름 고정(udev) + can_up.sh
    [B601-original.urdf, D435_Gemini2_Mount.stl, base_link.stl, base_link_no_plate.stl, cansimple_vectors.csv, colored_base_link_hardware_black_no_plate.stl, colored_base_link_matte_black_no_plate.stl, colored_base_link_silver_trim.stl]
2026-11-09 노트북 패드 → UDP → 라파 텔레옵, 게임패드 부호 수정, can_up.sh 라파 대응
    - udp_teleop_bridge.py (라파): UDP 5005 → /cmd_vel, 0.3 s 끊기면 0 → 발행 중단(HOLD), 상태 5 Hz 회신
    - virtual_pad.py: --udp 모드 (노트북 ROS 불필요) + 노트북 게임패드 입력 (gamepad_map·yaml 공유)
    - shaks_s0.yaml: scale_linear_y / scale_angular 부호 + 로 (joy 규약, 실기 회전 반대 수정)
    - test_directions.py: 가상 패드·joy·pygame 세 경로 방향 일치를 실제 yaml 로 시험
    - can_up.sh: restart-ms 미지원 드라이버(라파 6.8-raspi gs_usb) 대응, 실제 적용값 표시
    Cla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
2026-11-10 구동 브리지: 순간 엔코더 에러(0x100) 자동 복구, Hall 기록 도구·문서
    - ACTIVE 중 axis_error == ENCODER_FAILED 하나뿐이면 그 축만 클리어 + CLOSED_LOOP 재진입 (복구 중 전 축 속도 0)
    - 1 s 안에 복귀 못 함 / 10 s 안 3회 초과 / 다른 에러 비트 / heartbeat 끊김 → 기존대로 FAULT
    - 파라미터 encoder_recover, recover_max, recover_window, recover_timeout, recover_retry
    - gtest 11개 추가
    - hall_log.py (USB Hall 상태 CSV 기록), FL_hall_error.md, CLI.md
    Claude-Session: https://claude.ai/code/session_01L8Uk5fSNGpXSR86i9qj8re
2026-11-10 리프트 패드 연동: lift_bridge (Pico 시리얼), 종료 시 최하단 주차 · 켤 때 자동 원점
    - lift_bridge 패키지: Pico (yor-lift-position-v1) ↔ /lift_cmd, /lift_state
    - 조그 (반전 시 정지 확인 후), 명령 0.3 s 끊기면 정지
    - 주차: move_to 10 mm → 원점 해제 → 엔코더 카운트로 0 mm 까지 → 잔차 기록 후 재등록
    - Ctrl+C 종료 시 주차, 다음 실행 때 주차 기록이 있으면 자동 원점 등록
    - mm/count 불일치 경고, 내려가지 못하면 원점 오등록 대신 실패
    - 테스트: 동료 펌웨어 PositionController + 리프트 모델로 13 시나리오
    - capstone_msgs: LiftCommand, LiftState
    - teleop: UDP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
2026-11-10 리프트 패드 연동: lift_bridge (Pico 시리얼), 종료 시 최하단 주차 · 켤 때 자동 원점
    - 조그 (반전 시 정지 확인 후, 0.3 → 목표 PWM 램프, 원점 미등록이면 50 % 상한), 명령 0.3 s 끊기면 정지
    - 테스트: 동료 펌웨어 PositionController + 리프트 모델로 15 시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
2026-11-10 가상 패드 십자키 = 속도 상한 조절, 리프트 통신 오류 자동 해제
    - 게임패드 십자 위/아래 = 선속도 상한 ± 0.05 m/s (0.05..0.6), 오른쪽/왼쪽 = 각속도 상한 ± 0.1 rad/s (0.1..2.0)
    누르고 있으면 반복, 스틱 끝 = 지금 상한 (yaml scale 은 부호에만), 리프트 느린 조그에서 십자 제외
    - lift_bridge: bad_json / line_too_long / bad_command / command_timeout 은 1 s 안에 자동 clear
    (연결 직후 ttyACM 에 들어오는 이상한 줄로 Pico 가 bad_json 에 걸려 있던 문제). 진짜 fault 는 수동 해제 유지
    - 오류 안내 문구 LB 로 수정, CLI.md 십자키 표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
    [lift_bridge_node.py, lift_logic.py]
2026-11-11 README: 리프트 연동 구조 · lift_bridge · 패드 키 조작표
    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
2026-11-11 구동 브리지: 켤 때 보드에 남은 에러 클리어, 자동 복구 한도 10회/10 s
    - clear_on_start: 축마다 첫 heartbeat 에 에러가 있으면 한 번 클리어 → FAULT 뒤 브리지 재시작만으로 복귀
    (지운 뒤에도 다시 오면 평소처럼 FAULT)
    - recover_max 3 → 10 (2026-11-11 실측 최대 10 s 4회로 3회 한도에 걸림)
    - gtest 4개 추가
    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
